jbussmann/8-Cell-Balancer/Hardware/Pictures/3D_Top.png

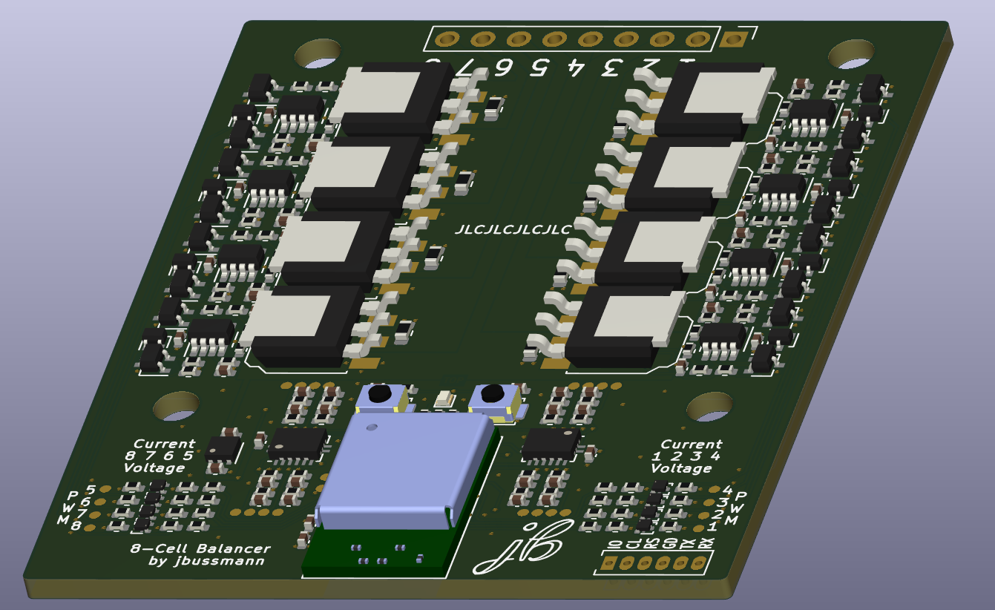
Hardware/Pictures/3D_Top.png
