jbussmann/8-Cell-Balancer/Hardware/PDF/8-Cell Balancer.pdf

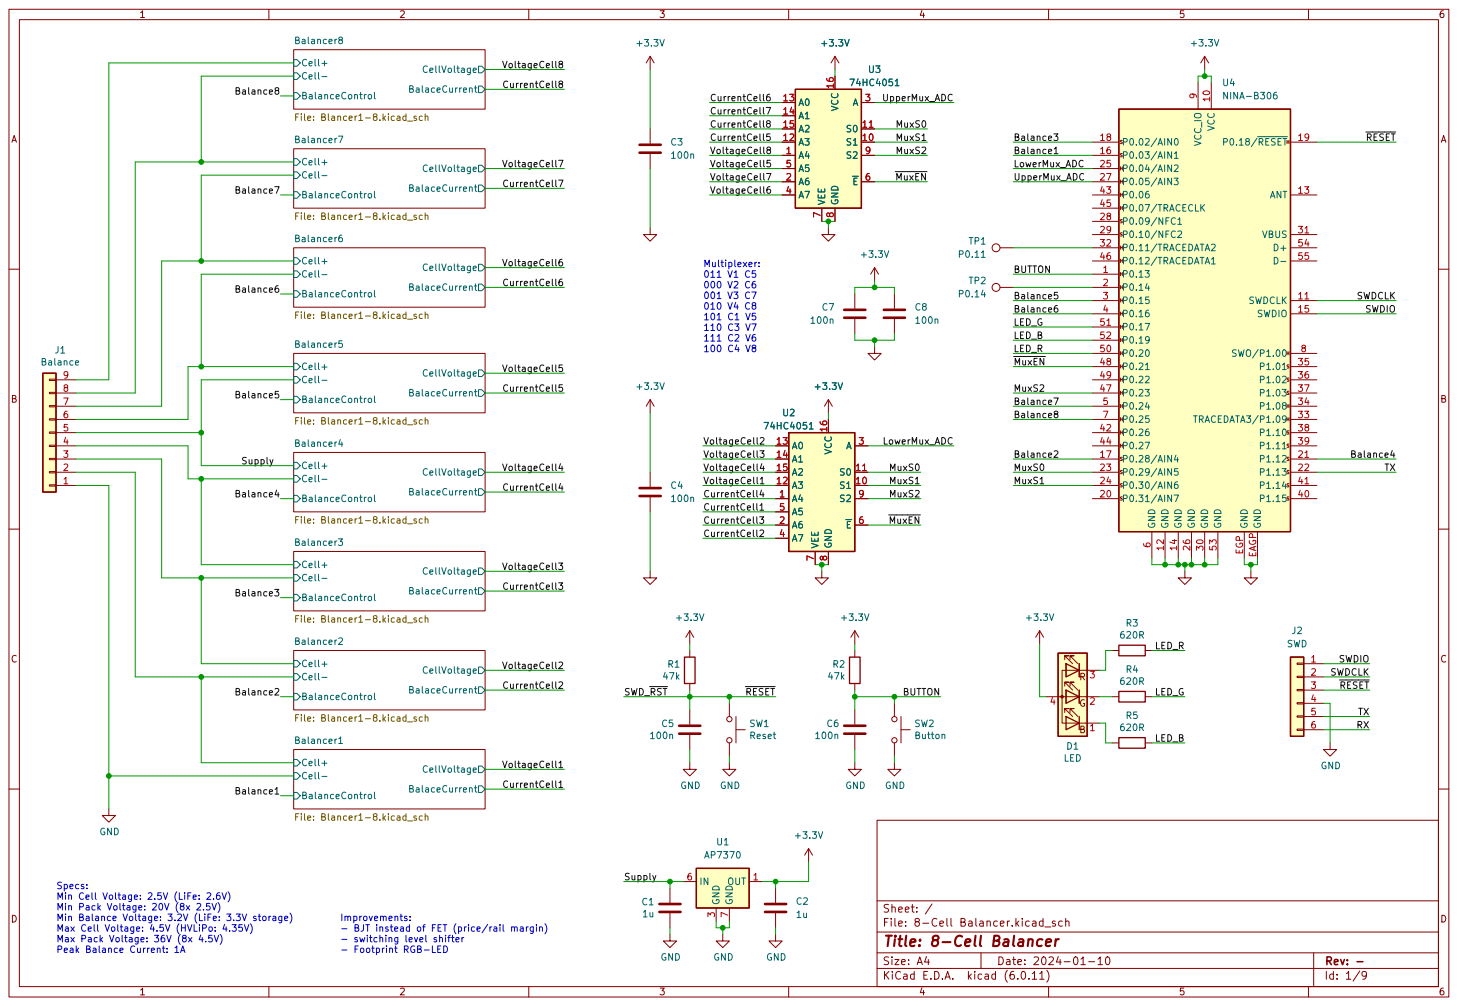
[picture p2: page 1]

9 GND EAGP GND EGP U4 NINA-B306 A4

Specs: Min Cell Voltage: 2.5V (LiFe: 2.6V) Min Pack Voltage: 20V (8x 2.5V) Min Balance Voltage: 3.2V (LiFe: 3.3V storage) Max Cell Voltage: 4.5V (HVLiPo: 4.35V) Max Pack Voltage: 36V (8x 4.5V) Peak Balance Current: 1A

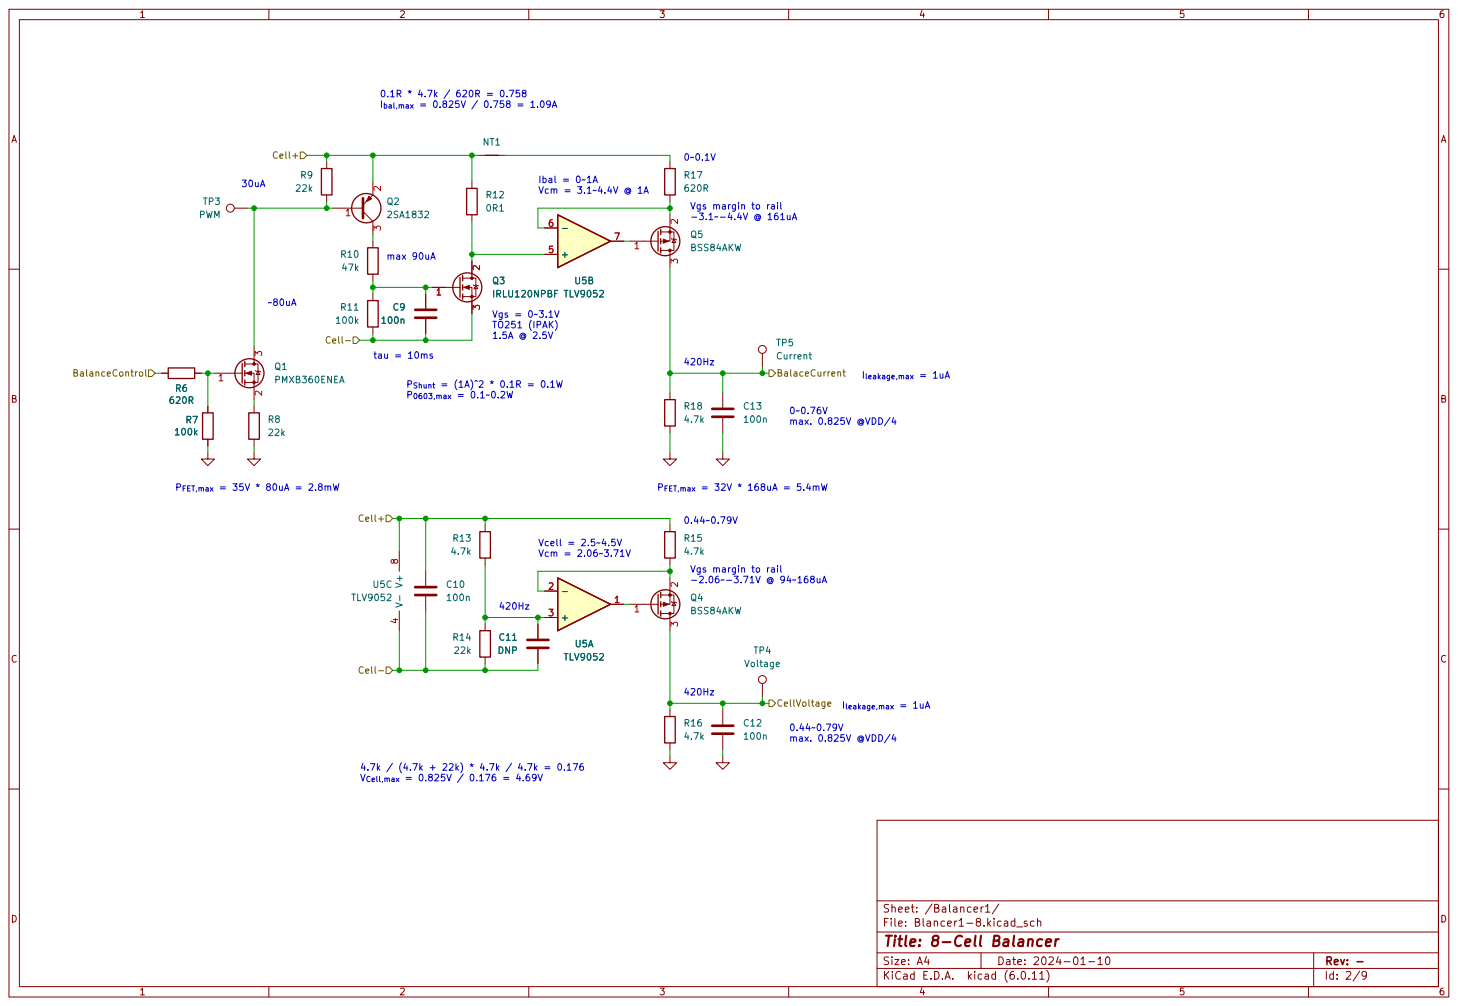
[picture p3: page 2]

0.44~0.79V max. 0.825V @VDD/4 P_{FET,max} = 32V * 168uA = 5.4mW

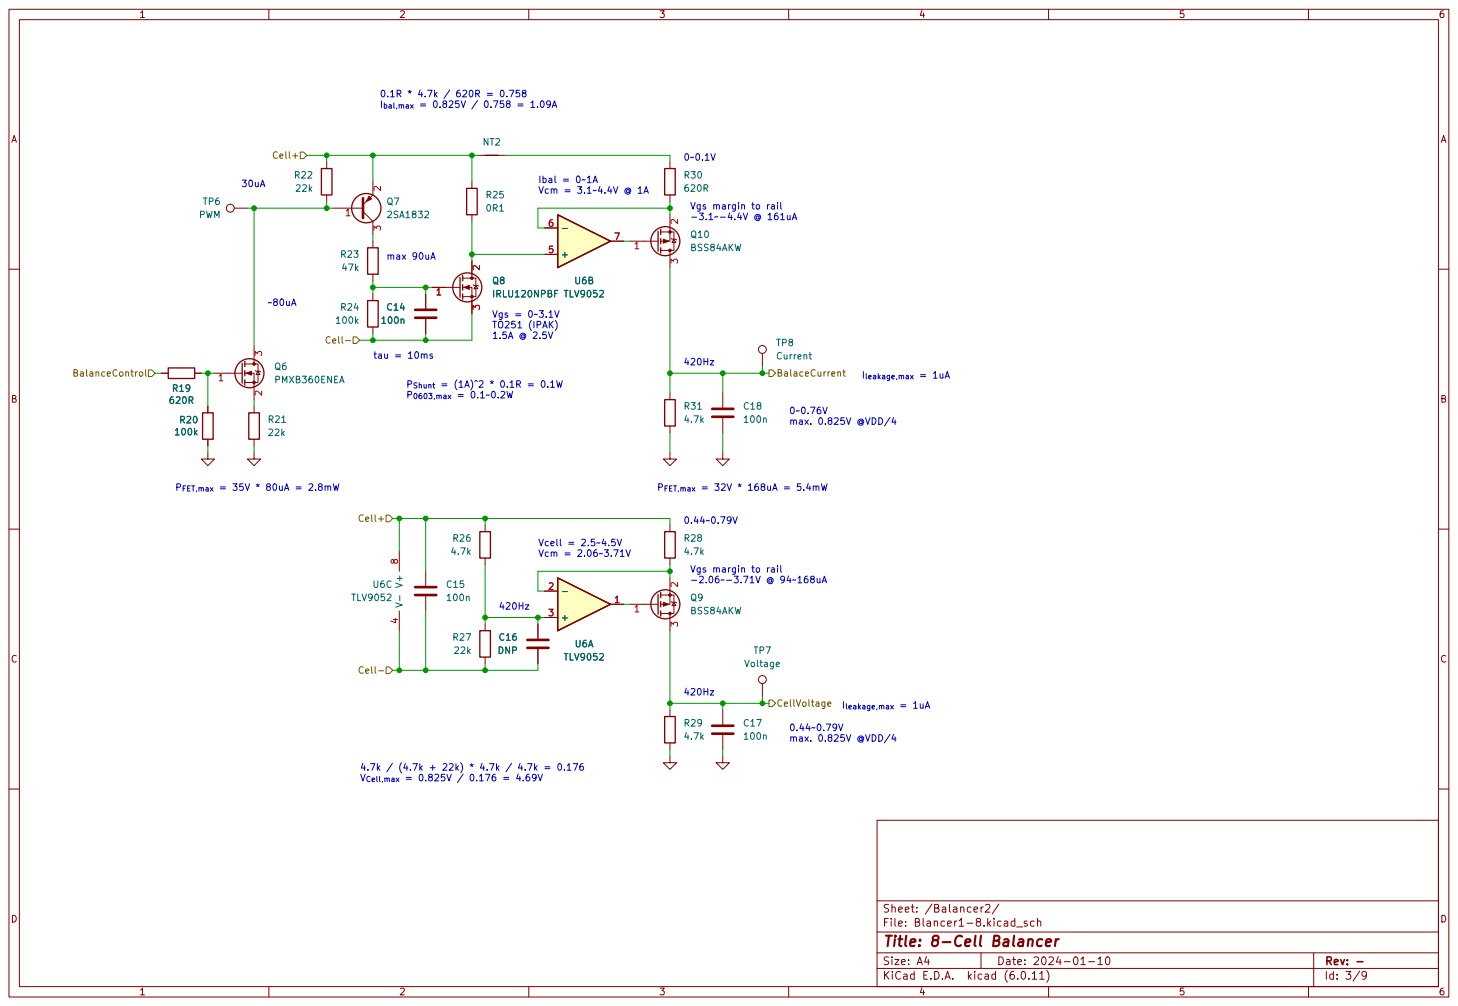
[picture p4: page 3]

0.44~0.79V max. 0.825V @VDD/4 P_{FET,max} = 32V * 168uA = 5.4mW

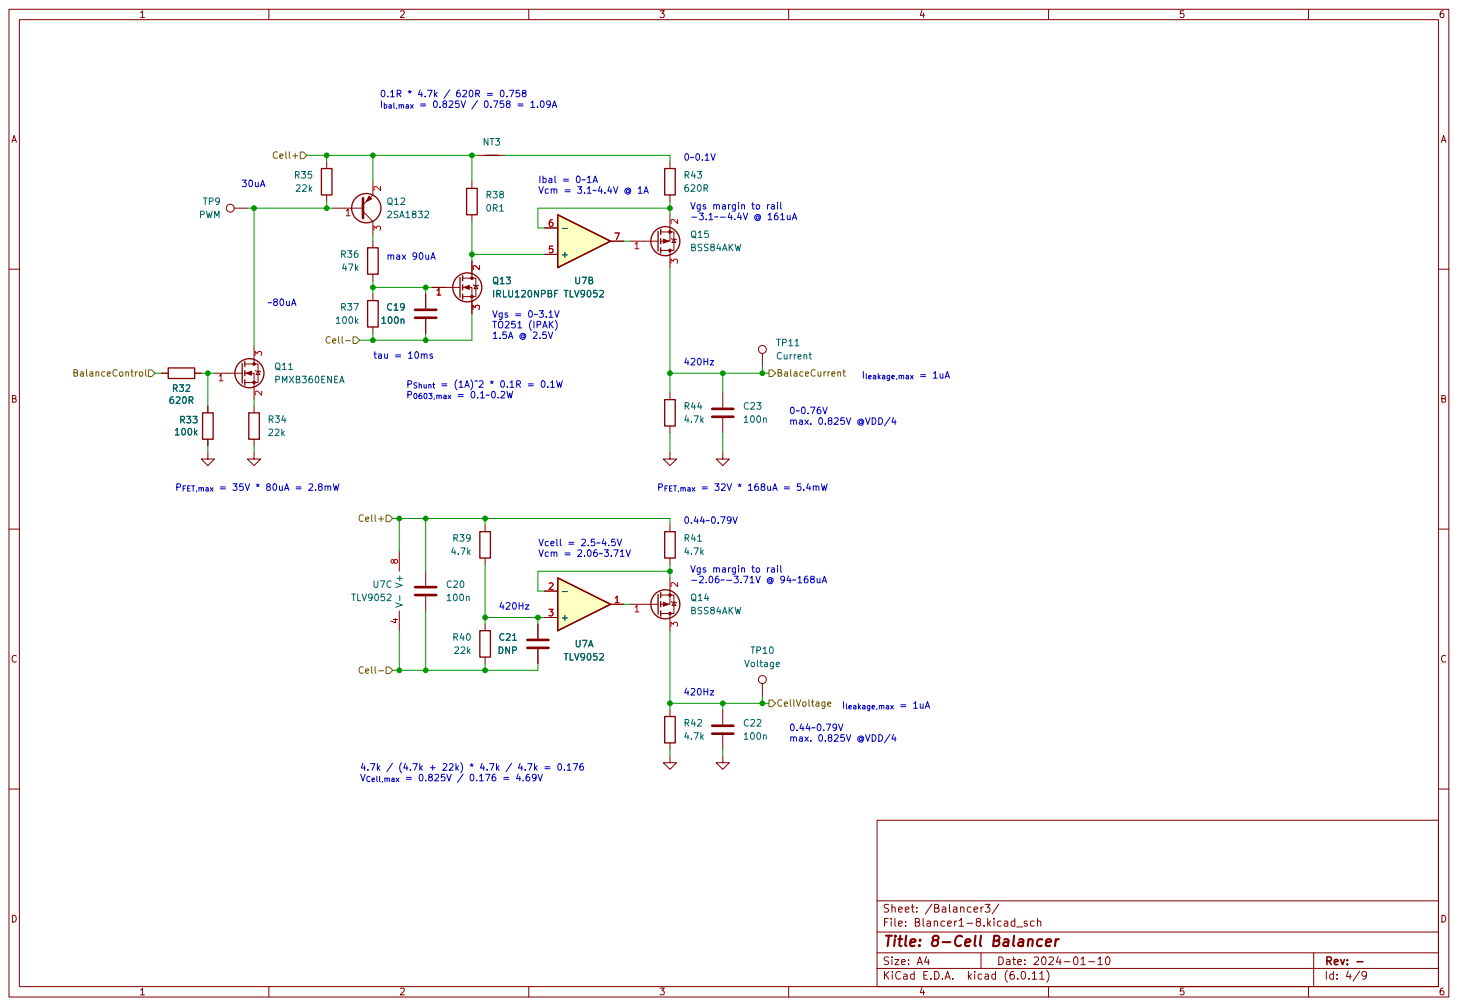
[picture p5: page 4]

0.44~0.79V max. 0.825V @VDD/4 P_{FET,max} = 32V * 168uA = 5.4mW

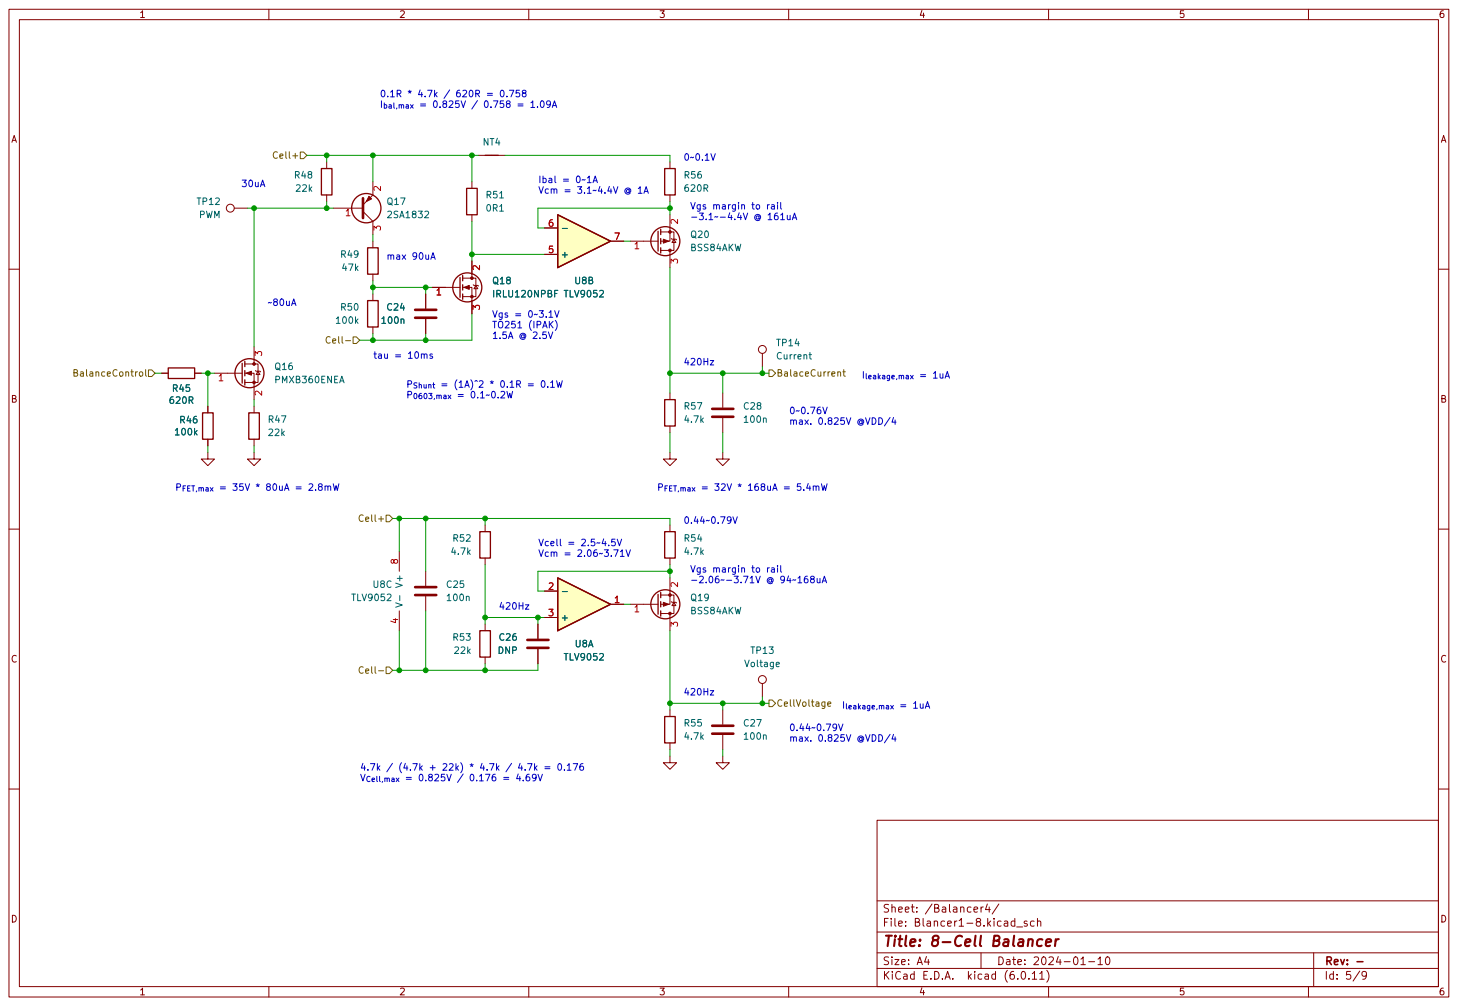
[picture p6: page 5]

0.44~0.79V max. 0.825V @VDD/4 P_{FET,max} = 32V * 168uA = 5.4mW

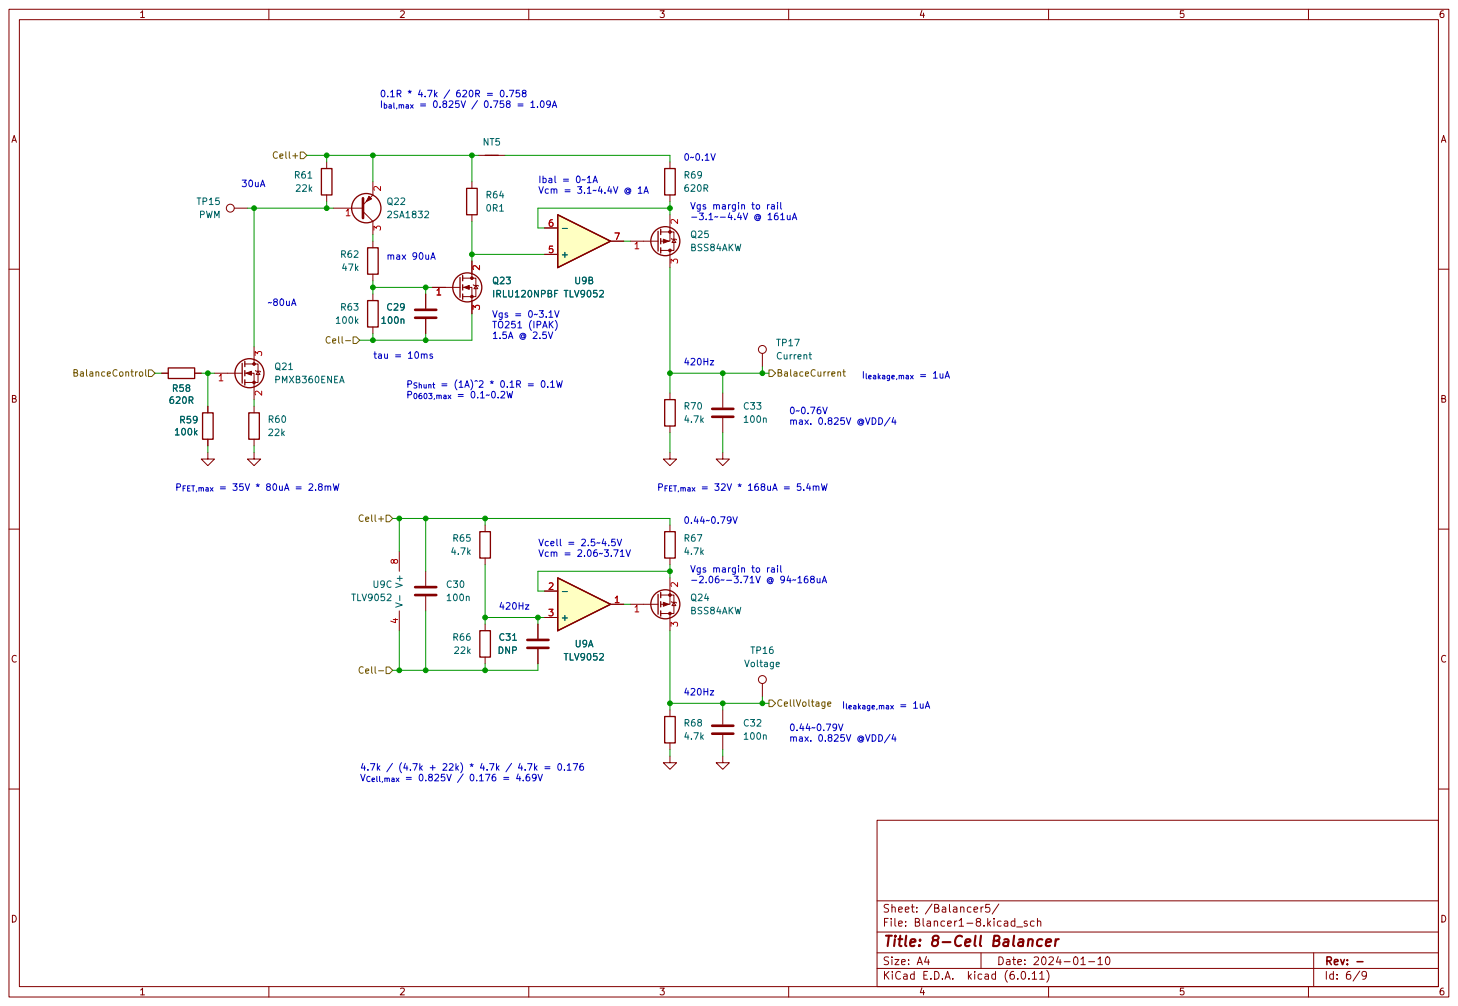
[picture p7: page 6]

0.44~0.79V max. 0.825V @VDD/4 P_{FET,max} = 32V * 168uA = 5.4mW

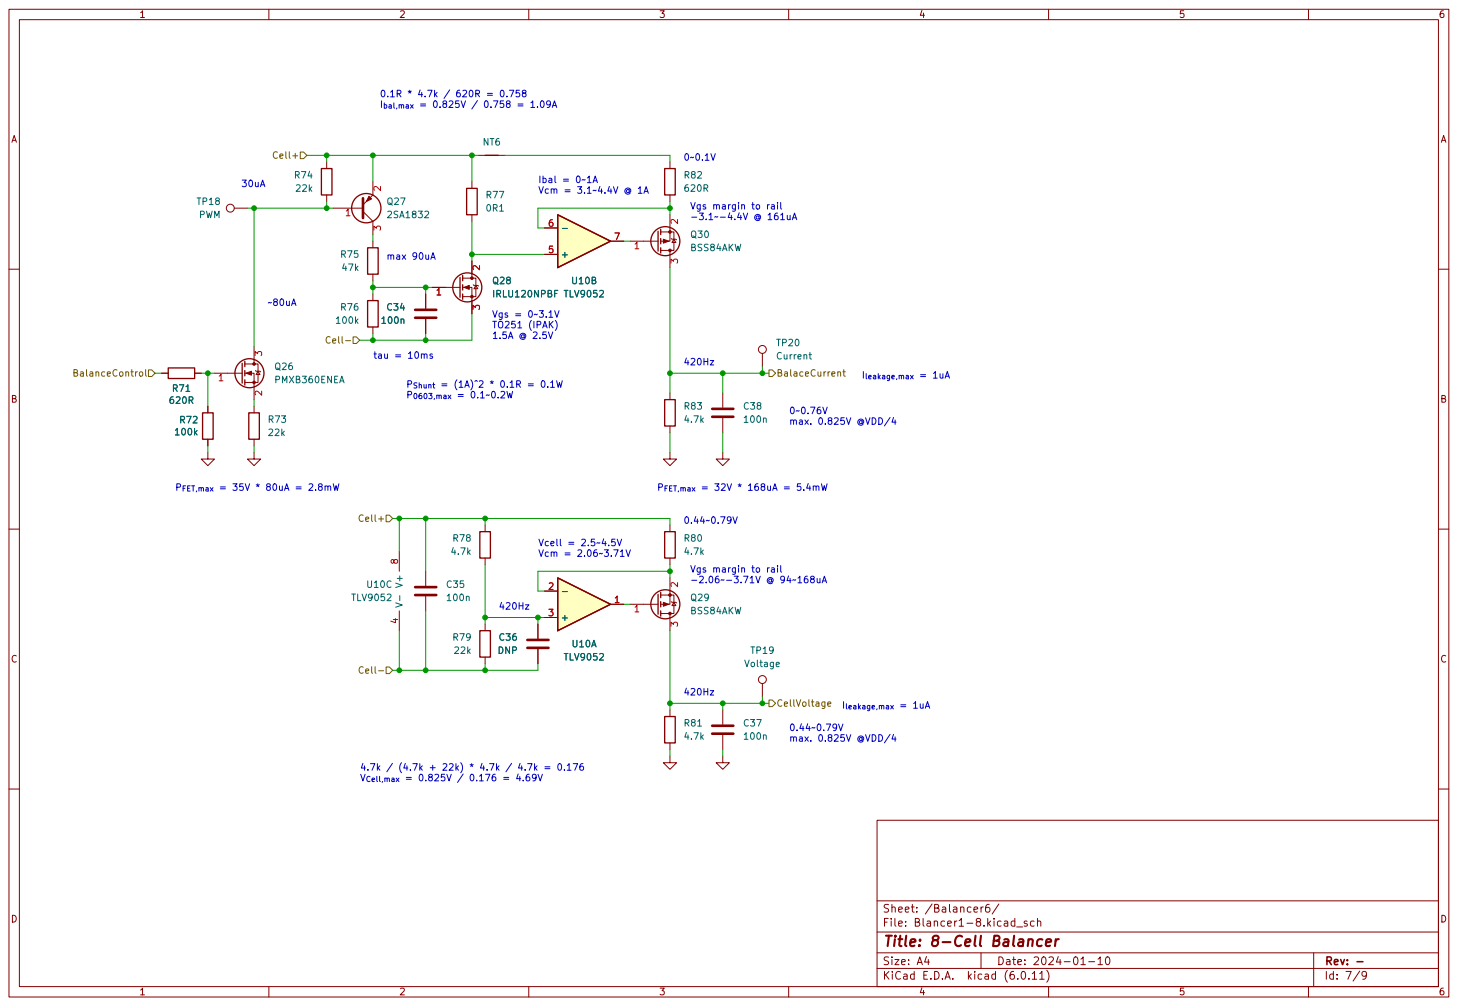
[picture p8: page 7]

0.44~0.79V max. 0.825V @VDD/4 P_{FET,max} = 32V * 168uA = 5.4mW

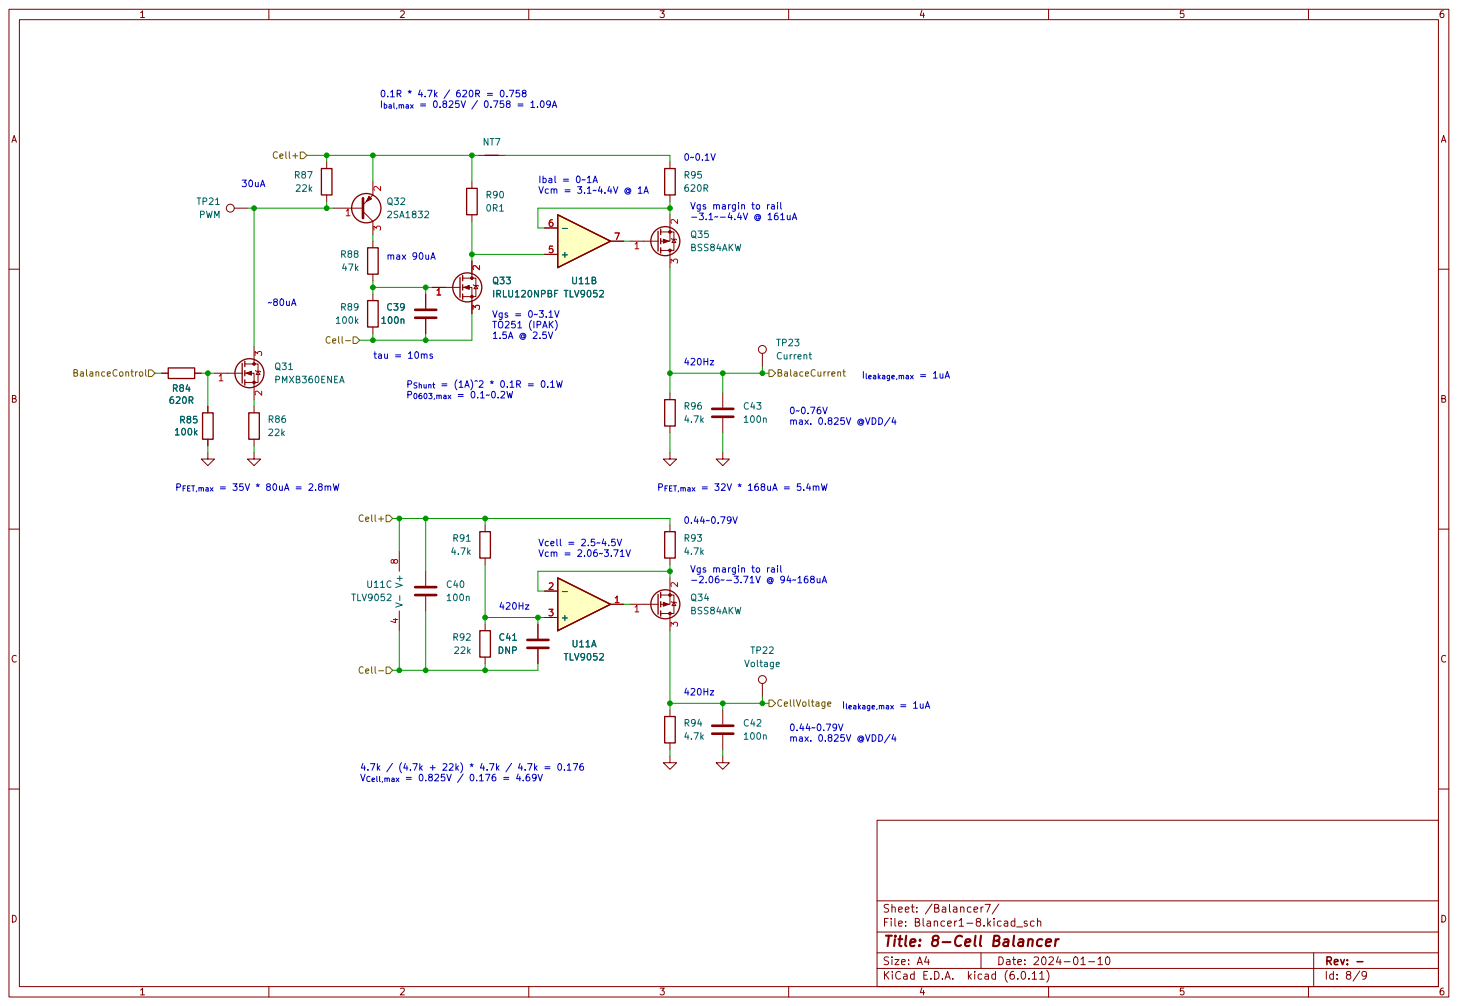
[picture p9: page 8]

0.44~0.79V max. 0.825V @VDD/4 P_{FET,max} = 32V * 168uA = 5.4mW

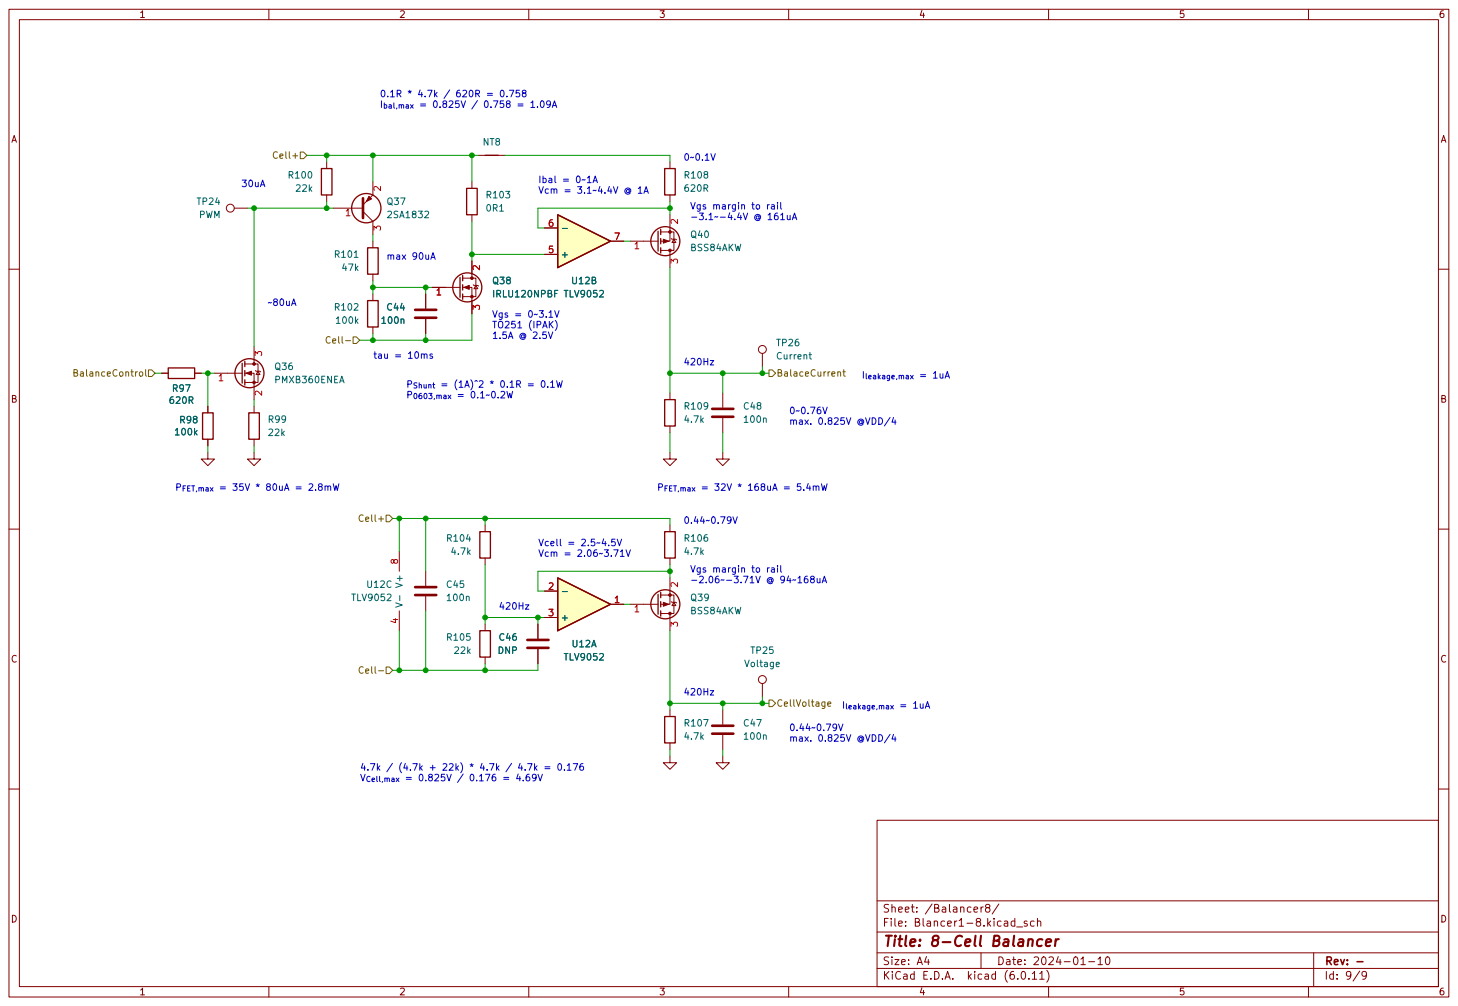
[picture p10: page 9]

0.44~0.79V max. 0.825V @VDD/4 P_{FET,max} = 32V * 168uA = 5.4mW
