jbussmann/8-Cell-Balancer/Notes/Hardware.pdf

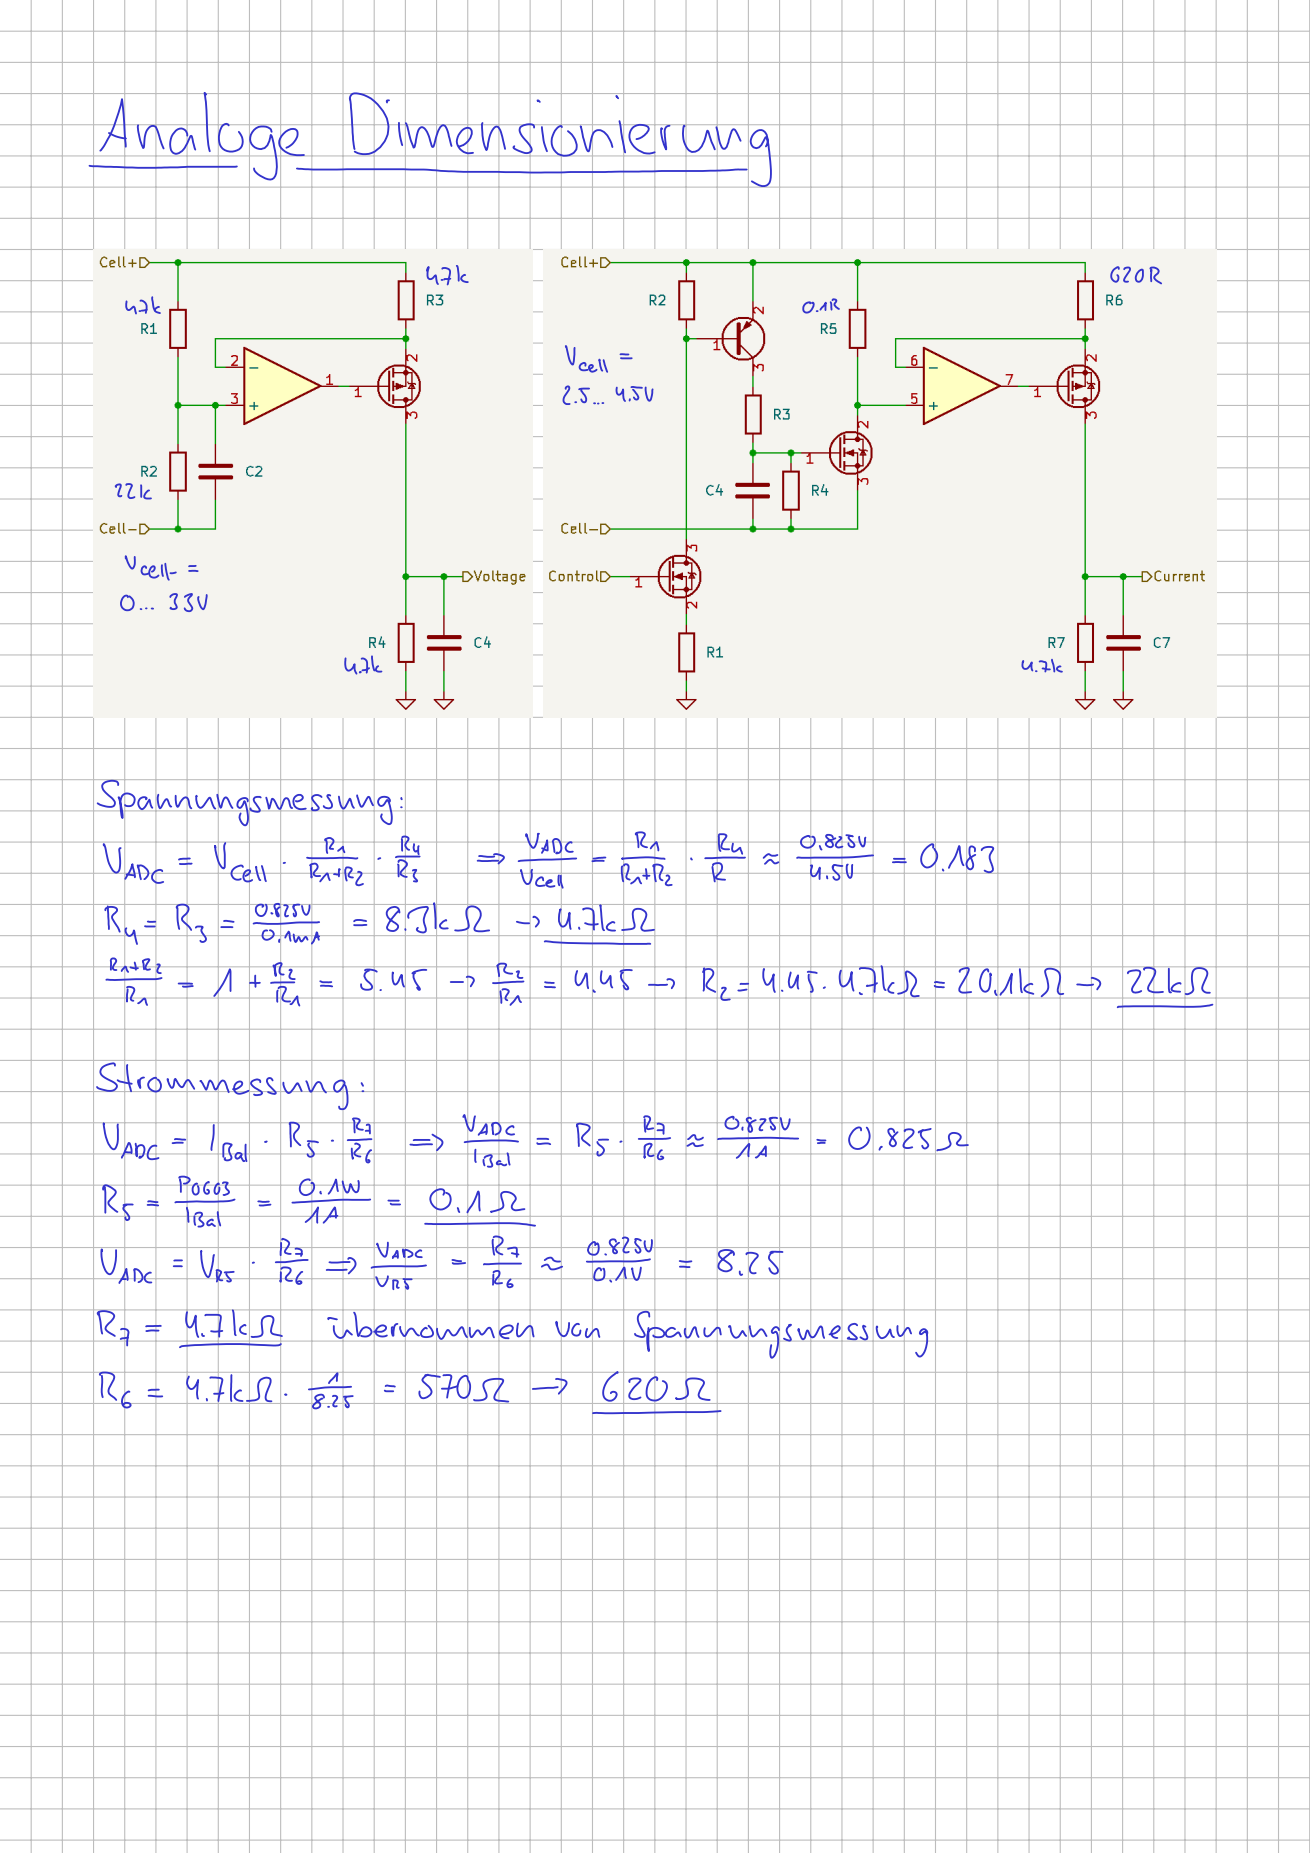
[picture p11: page 1]

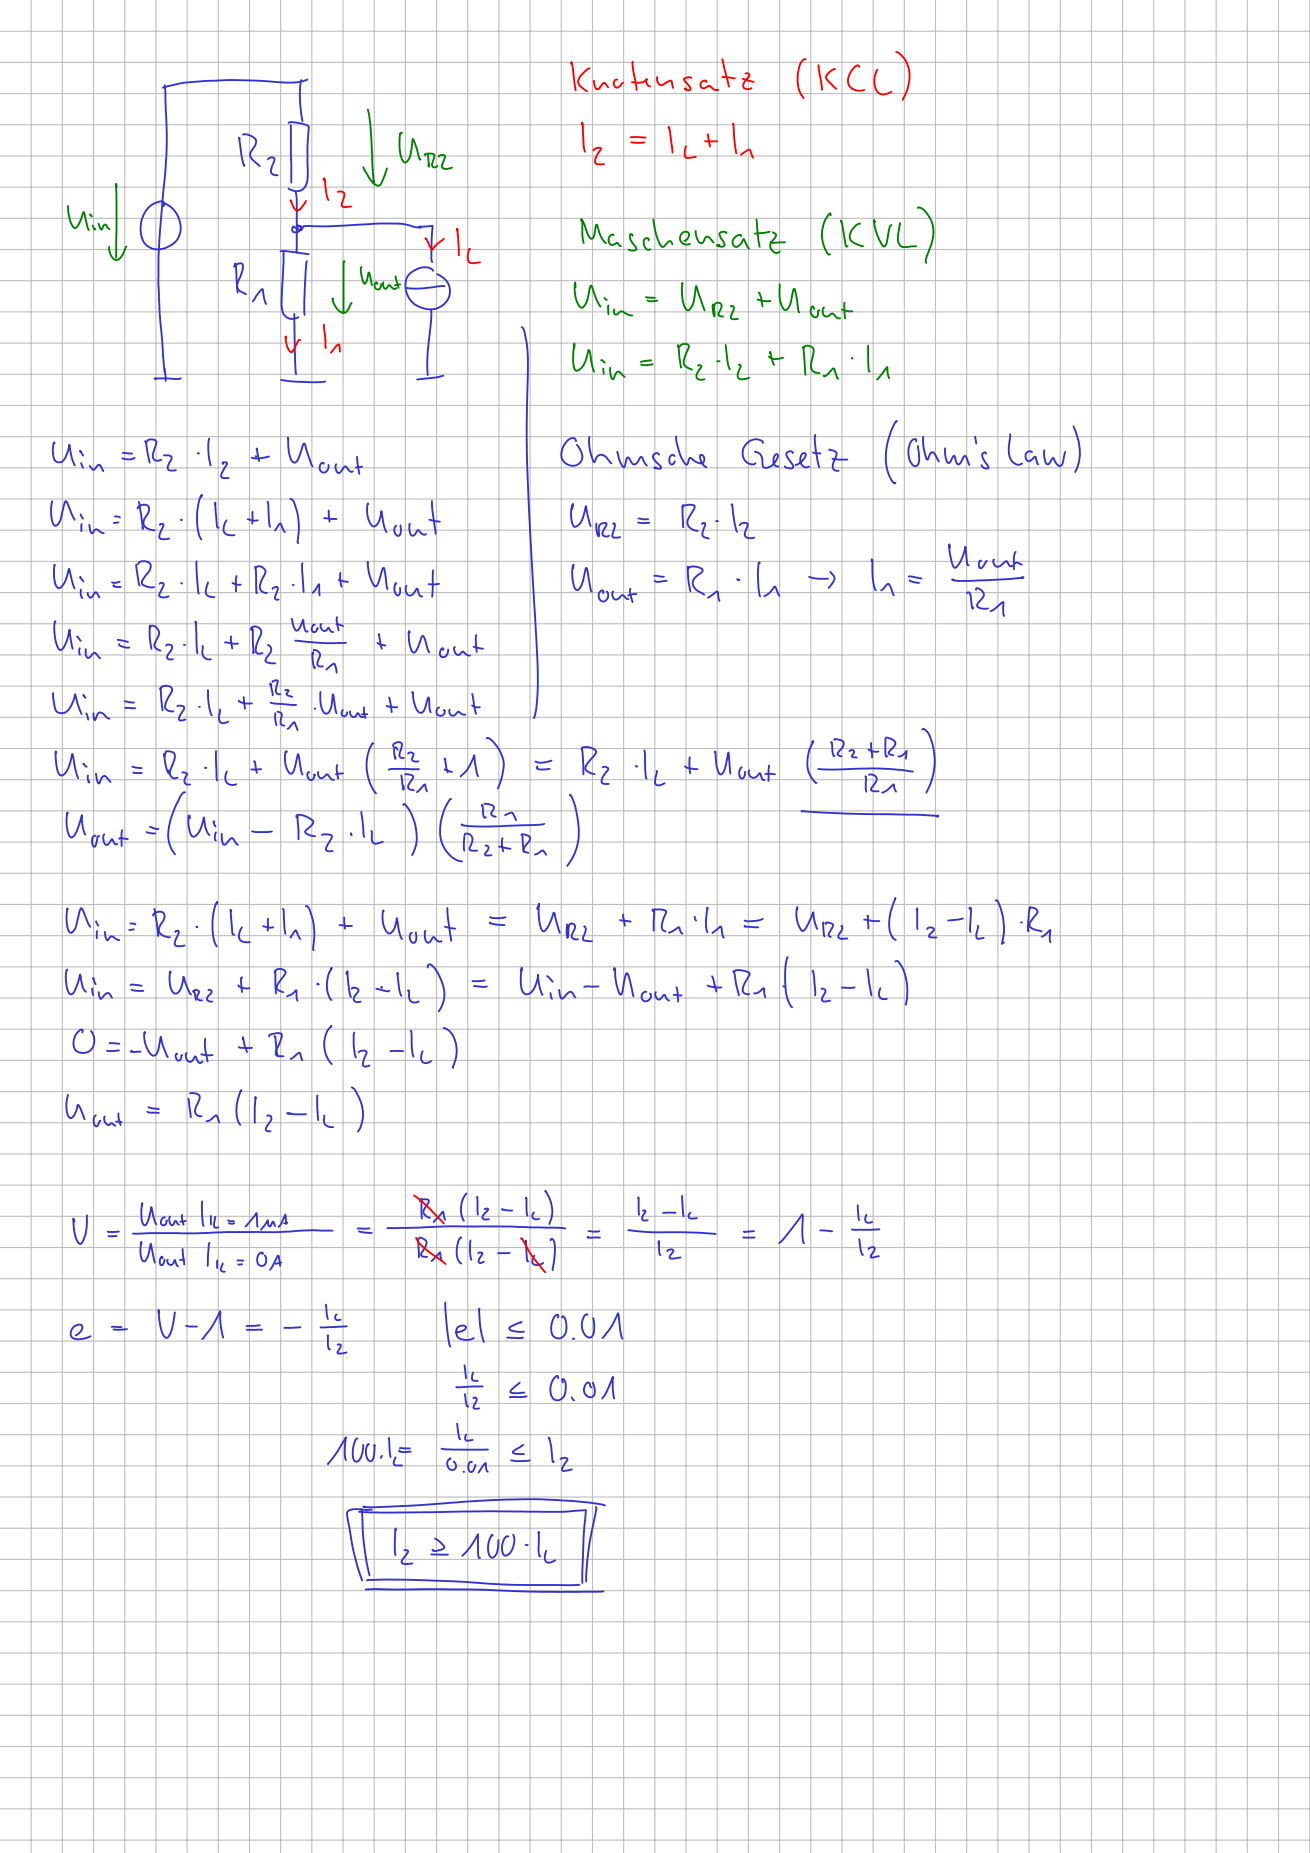
[picture p12: page 2]
