jbussmann/8-Cell-Balancer/Spice/Level-Shifter_Capacitor.asc

C1: cap; 3.3n
C2: cap; 100n
D1: diode; Diode
D2: diode; Diode
D3: diode; Diode
M1: nmos; Power-FET
R1: res; 6.6k
R2: res; 330k
R3: res; 0.1
V1: voltage; PULSE(0 3.3 3m 1n 1n 50u 100u 90); Rser=200
V2: voltage; PULSE(0 30 1m 1n 1n 14m)
V3: voltage; PULSE(0 3.6 2m 1n 1n 13m)
Named nets: 0, Cell-, Cell+
.tran 25m startup
- high turn on current
- what happens on turn off? MOSFET requires gate protection
.model Diode D(Ron=1 Roff=1G Vfwd=0.3)
 
.MODEL Power-FET NMOS LEVEL=1 IS=1e-32
+VTO=1.53268 LAMBDA=0.00113312 KP=2.28626
+CGSO=3.98923e-06 CGDO=3.14722e-07
tau = 33us
Std drive: 0.4V / 0.002A = 200Ohm
High drive: 0.4V / 0.01A = 40Ohm
