jbussmann/8-Cell-Balancer/Spice/Balancer_current.asc

C1: cap; 100n
C2: cap; 100n
D1: diode
M1: pmos
M2: nmos
M3: nmos
R1: res; 0.1
R2: res; 270k
R3: res; 330k
R4: res; 10k
R5: res; 10k
R6: res; 100k
R9: res; 200k
U1: UniversalOpAmp2
V1: voltage; PWL(0 2.5 200m 2.5 800m 4.5 1 4.5)
V2: voltage; 20
V3: voltage; PULSE(0 3.3 0 0 0 0.08m 0.1m 505)
Named nets: 0
.tran 100m
