jbussmann/8-Cell-Balancer/Spice/Balancer_voltage.asc

C1: cap; 00n
C2: cap; 100n
C4: cap; 100n
M1: pmos; P-MOS
R1: res; 4.7k
R2: res; 22k
R3: res; 4.7k
R4: res; 4.7k
U1: UniversalOpAmp2
V1: voltage; PWL(0 2.5 100m 2.5 400m 4.5 480m 4.5 490m 2.5 600m 2.5 900m 4.5 1 4.5); AC 1
V2: voltage; PWL(0 0 510m 0 520m 20 1 20)
Named nets: 0, Vg, Vs, Vd
.ac dec 100 1 1meg
.MODEL P-MOS PMOS(Vto=-1.66 Kp=1.3807e-01
+ Nfs=1000000000 Eta=0 Level=3 L=1e-4 W=1e-4 
+ Gamma=0 Phi=0.6 Is=1e-24 Js=0 Pb=0.8  Cj=0 
+ Cjsw=0 Cgso=0 Cgdo=0 Cgbo=0 Tox=1e-07 Xj=0
+ U0=600 Vmax=3000)
