jbussmann/8-Cell-Balancer/Spice/Level-Shifter_Transistor.asc

C2: cap; 100n
M1: nmos; Power-FET
M2: nmos; Power-FET
Q1: pnp
R1: res; 47k
R2: res; 100k
R3: res; 0.1
R4: res; 22k
R5: res; 22k
R6: res; 100k
R7: res; 620
V1: voltage; PULSE(0 3.3 3m 1n 1n 90u 100u 140)
V2: voltage; PULSE(0 30 1m 1n 1n 19m)
V3: voltage; PULSE(0 4.35 2m 1n 1n 18m)
Named nets: 0, Cell-, Cell+
.tran 25m startup
- more parts
- dependant on cell voltage
.MODEL Diode D(Ron=1 Roff=1G Vfwd=0.3)
 
.MODEL Power-FET NMOS LEVEL=1 IS=1e-32
+ VTO=1.53268 LAMBDA=0.00113312 KP=2.28626
+ CGSO=3.98923e-06 CGDO=3.14722e-07
 
.MODEL PNP PNP(LEVEL=1 TNOM=25 IS=2.5e-014 
+ BF=190 NF=1 VAF=30 IKF=0.3 ISE=1E-016 
+ NE=1.5 BR=15 NR=1 VAR=1000 IKR=0.01 
+ ISC=4e-013 NC=1.4 NK=0.53 RE=0.001 
+ RB=8 RC=1.1 CJE=9.0E-012 VJE=0.75 MJE=0.33 
+ CJC=9.63E-012 VJC=0.75 MJC=0.33 FC=0.5 
+ TR=4e-008 TF=1.78E-009 XTF=1 VTF=1 ITF=1 
+ PTF=0 EG=1.11 TRC1=0 XTB=2 XTI=2)
 
.MODEL N-MOS NMOS(Vto=2.13003650017072 
+ Kp=7.411324e+000 Nfs=500000000000 Eta=5000 
+ Level=3 L=1e-4 W=1e-4 Gamma=0 Phi=0.6 
+ Is=1e-24 Js=0 Pb=0.8 Cj=0 Cjsw=0 Cgso=0 
+ Cgdo=0 Cgbo=0 Tox=1e-07 Xj=0 U0=600 Vmax=2000)
