jbussmann/8-Cell-Balancer/Hardware/8-Cell Balancer.kicad_pcb

## KiCad design Hardware/8-Cell Balancer.kicad_pcb (2025-03-06)

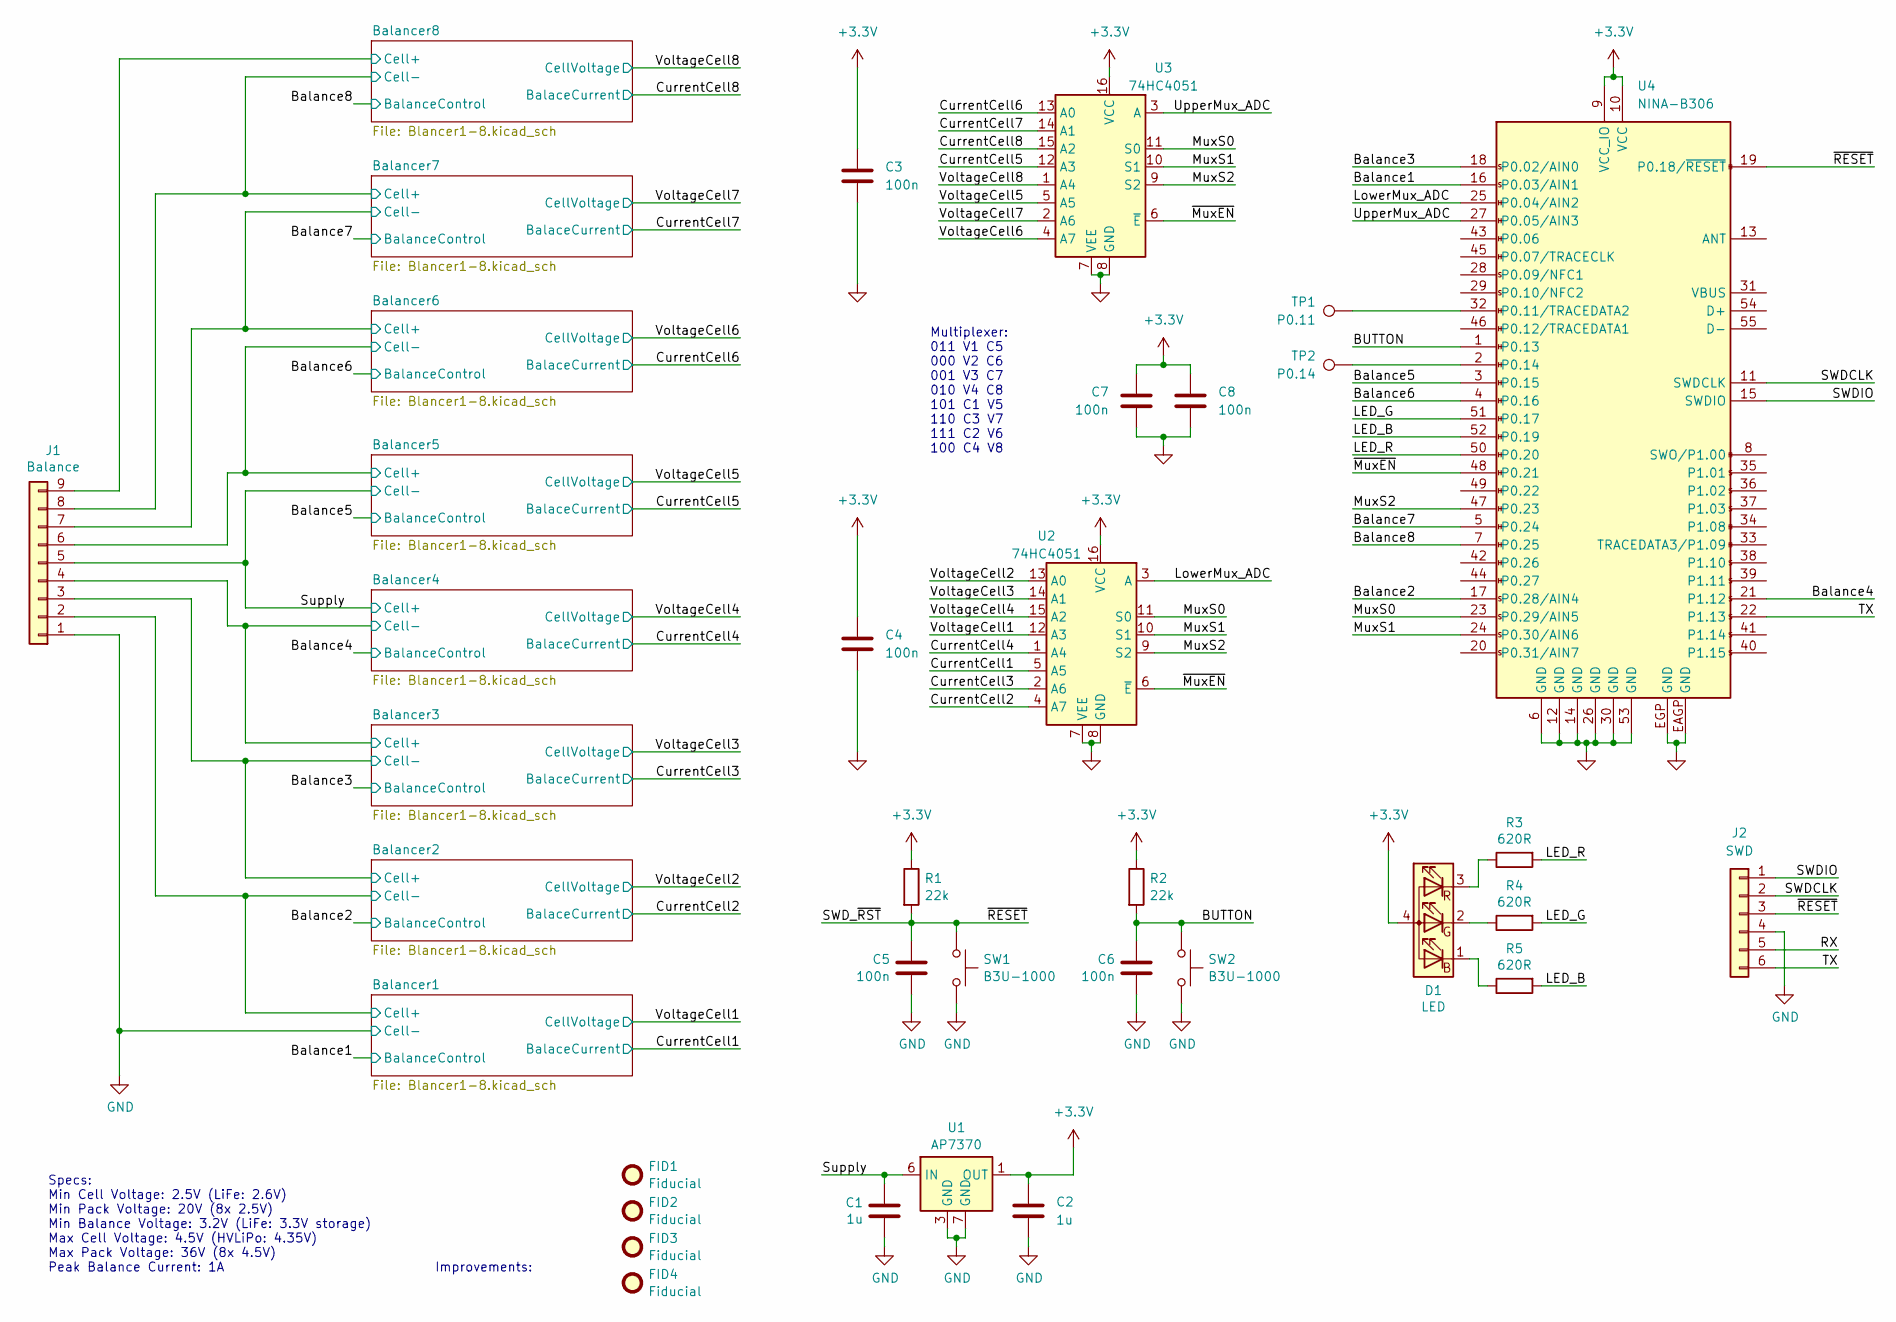
[picture p18: schematic 8-Cell Balancer.kicad_sch]

Parts:
C1, C2: 1u; C_0603_1608Metric; Mfr. Part# GRT188R61H105KE13D; Mouser Part# 81-GRT188R61H105KE3D
C3, C4, C5, C6, C7, C8: 100n; C_0402_1005Metric; Mfr. Part# GRM155R71C104KA88D; Mouser Part# 81-GRM155R71C104KA88
D1: LED; LED_RGB_1x1mm; Mfr. Part# UHD1110-FKA-CL1A13r3q1BBQFMF3; Mouser Part# 941-UHD0FKAC11BQFMF3
FID1, FID2, FID3, FID4: Fiducial; Fiducial_1mm_Mask2mm
J1: Balance; PinHeader_1x09_P2.54mm_Vertical
J2: SWD; PinHeader_1x06_P1.27mm_Vertical
R1, R2: 22k; R_0402_1005Metric; Mfr. Part# RC0402FR-0722KL; Mouser Part# 603-RC0402FR-0722KL
R3, R4, R5: 620R; R_0402_1005Metric; Mfr. Part# RC0402FR-07620RL; Mouser Part# 603-RC0402FR-07620RL
SW1, SW2: B3U-1000; Button_B3U-1000; Mfr. Part# B3U-1000P-B; Mouser Part# 653-B3U-1000P-B
TP1: P0.11; TestPoint_Pad_D1.0mm
TP2: P0.14; TestPoint_Pad_D1.0mm
U1: AP7370; Diodes_UDFN2020-6; Mfr. Part# AP7370-33FDC-7; Mouser Part# 621-AP7370-33FDC-7
U2, U3: 74HC4051; QFN-16-1EP_2.5x3.5mm_P0.5mm_EP1x2.5mm; Mfr. Part# 74LV4051BQ,115; Mouser Part# 771-LV4051BQ115
U4: NINA-B306; Module_ublox_NINA-B306; Mfr. Part# NINA-B306-00B; Mouser Part# 377-NINA-B306-00B

Connections:
+3.3V: C2.1, C3.1, C4.1, C7.1, C8.1, D1.4 (A), R1.1, R2.1, U1.1 (OUT), U2.16 (VCC), U3.16 (VCC), U4.9 (VCC_IO), U4.10 (VCC)
/BUTTON: C6.1, R2.2, SW2.1, U4.1 (P0.13)
/Balance1: U4.16 (P0.03/AIN1); also elsewhere on the board
/Balance2: U4.17 (P0.28/AIN4); also elsewhere on the board
/Balance3: U4.18 (P0.02/AIN0); also elsewhere on the board
/Balance4: U4.21 (P1.12); also elsewhere on the board
/Balance5: U4.3 (P0.15); also elsewhere on the board
/Balance6: U4.4 (P0.16); also elsewhere on the board
/Balance7: U4.5 (P0.24); also elsewhere on the board
/Balance8: U4.7 (P0.25); also elsewhere on the board
/Balancer1/Cell+: J1.2; also elsewhere on the board
/Balancer2/Cell+: J1.3; also elsewhere on the board
/Balancer3/Cell+: J1.4; also elsewhere on the board
/Balancer5/Cell+: J1.6; also elsewhere on the board
/Balancer6/Cell+: J1.7; also elsewhere on the board
/Balancer7/Cell+: J1.8; also elsewhere on the board
/Balancer8/Cell+: J1.9; also elsewhere on the board
/CurrentCell1: U2.5 (A5); also elsewhere on the board
/CurrentCell2: U2.4 (A7); also elsewhere on the board
/CurrentCell3: U2.2 (A6); also elsewhere on the board
/CurrentCell4: U2.1 (A4); also elsewhere on the board
/CurrentCell5: U3.12 (A3); also elsewhere on the board
/CurrentCell6: U3.13 (A0); also elsewhere on the board
/CurrentCell7: U3.14 (A1); also elsewhere on the board
/CurrentCell8: U3.15 (A2); also elsewhere on the board
/LED_B: R5.2, U4.52 (P0.19)
/LED_G: R4.2, U4.51 (P0.17)
/LED_R: R3.2, U4.50 (P0.20)
/LowerMux_ADC: U2.3 (A), U4.25 (P0.04/AIN2)
/MuxS0: U2.11 (S0), U3.11 (S0), U4.23 (P0.29/AIN5)
/MuxS1: U2.10 (S1), U3.10 (S1), U4.24 (P0.30/AIN6)
/MuxS2: U2.9 (S2), U3.9 (S2), U4.47 (P0.23)
/RX: J2.5
/SWDCLK: J2.2, U4.11 (SWDCLK)
/SWDIO: J2.1, U4.15 (SWDIO)
/SWD_~RST: C5.1, J2.3, R1.2, SW1.1, U4.19 (P0.18/~RESET)
/Supply: C1.1, J1.5, U1.6 (IN); also elsewhere on the board
/TX: J2.6, U4.22 (P1.13)
/UpperMux_ADC: U3.3 (A), U4.27 (P0.05/AIN3)
/VoltageCell1: U2.12 (A3); also elsewhere on the board
/VoltageCell2: U2.13 (A0); also elsewhere on the board
/VoltageCell3: U2.14 (A1); also elsewhere on the board
/VoltageCell4: U2.15 (A2); also elsewhere on the board
/VoltageCell5: U3.5 (A5); also elsewhere on the board
/VoltageCell6: U3.4 (A7); also elsewhere on the board
/VoltageCell7: U3.2 (A6); also elsewhere on the board
/VoltageCell8: U3.1 (A4); also elsewhere on the board
/~MuxEN: U2.6 (~E), U3.6 (~E), U4.48 (P0.21)
GND: C1.2, C2.2, C3.2, C4.2, C5.2, C6.2, C7.2, C8.2, J1.1, J2.4, SW1.2, SW2.2, U1.3 (GND), U1.7 (GND), U2.7 (VEE), U2.8 (GND), U3.7 (VEE), U3.8 (GND), U4.6 (GND), U4.12 (GND), U4.14 (GND), U4.26 (GND), U4.30 (GND), U4.53 (GND), U4.EAGP (GND), U4.EGP (GND); also elsewhere on the board
unnamed: D1.1 (BK), R5.1
unnamed: D1.2 (GK), R4.1
unnamed: D1.3 (RK), R3.1
unnamed: TP1.1, U4.32 (P0.11/TRACEDATA2)
unnamed: TP2.1, U4.2 (P0.14)

Notes on the sheet:
Improvements:
Specs: Min Cell Voltage: 2.5V (LiFe: 2.6V) Min Pack Voltage: 20V (8x 2.5V) Min Balance Voltage: 3.2V (LiFe: 3.3V storage) Max Cell Voltage: 4.5V (HVLiPo: 4.35V) Max Pack Voltage: 36V (8x 4.5V) Peak Balance Current: 1A
Multiplexer: 011 V1 C5 000 V2 C6 001 V3 C7 010 V4 C8 101 C1 V5 110 C3 V7 111 C2 V6 100 C4 V8

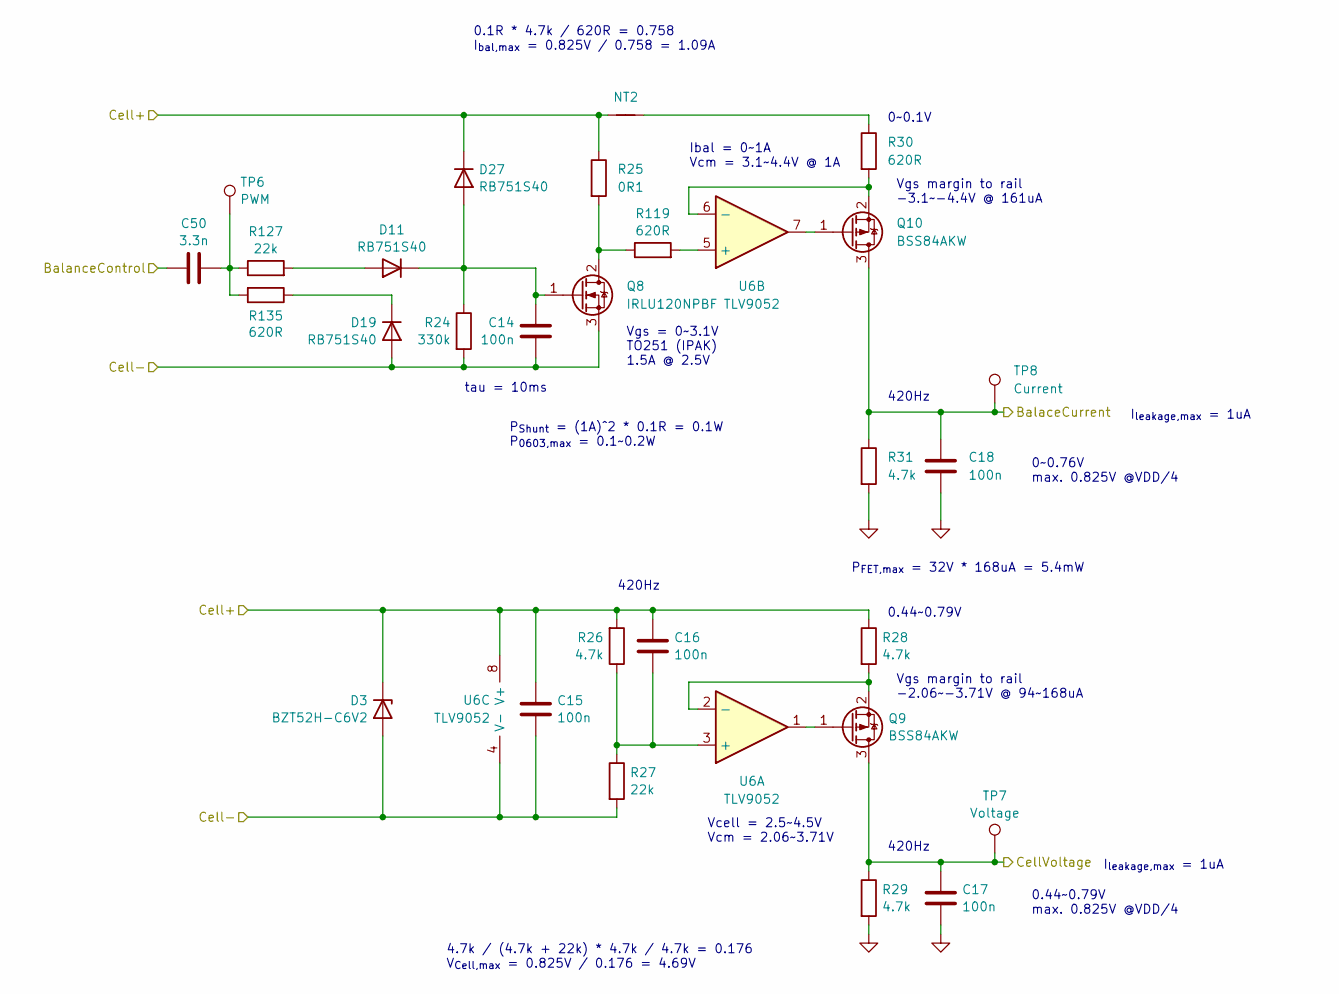
[picture p19: schematic Blancer1-8.kicad_sch, 8-Cell Balancer]

Parts:
C14, C15, C16, C17, C18: 100n; C_0402_1005Metric; Mfr. Part# GRM155R71C104KA88D; Mouser Part# 81-GRM155R71C104KA88
C50: 3.3n; C_0402_1005Metric; Mfr. Part# GRM1555C1H332JE01D; Mouser Part# 81-GRM1555C1H332JE1D
D3: BZT52H-C6V2; D_SOD-123F; Mfr. Part# BZT52H-C6V2,115; Mouser Part# 771-BZT52H-C6V2-T/R
D11, D19, D27: RB751S40; D_SOD-523; Mfr. Part# RB751S40T5G; Mouser Part# 863-RB751S40T5G
NT2: NetTie; NetTie-2_SMD_Pad0.127mm
Q8: IRLU120NPBF; TO-251-3_Flipped; Mfr. Part# IRLU120NPBF; Mouser Part# 942-IRLU120NPBF
Q9, Q10: BSS84AKW; SOT-323_SC-70; Mfr. Part# BSS84AKW,115; Mouser Part# 771-BSS84AKW115
R24: 330k; R_0402_1005Metric; Mfr. Part# RC0402FR-0722KL; Mouser Part# 603-RC0402FR-0722KL
R25: 0R1; R_0603_1608Metric; Mfr. Part# PT0603FR-7W0R1L; Mouser Part# 603-PT0603FR-7W0R1L
R26, R28, R29, R31: 4.7k; R_0402_1005Metric; Mfr. Part# RC0402FR-134K7L; Mouser Part# 603-RC0402FR-134K7L
R27, R127: 22k; R_0402_1005Metric; Mfr. Part# RC0402FR-0722KL; Mouser Part# 603-RC0402FR-0722KL
R30, R119, R135: 620R; R_0402_1005Metric; Mfr. Part# RC0402FR-07620RL; Mouser Part# 603-RC0402FR-07620RL
TP6: PWM; TestPoint_Pad_D1.0mm
TP7: Voltage; TestPoint_Pad_D1.0mm
TP8: Current; TestPoint_Pad_D1.0mm
U6: TLV9052; SOT-23-8; Mfr. Part# TLV9052IDDFR; Mouser Part# 595-TLV9052IDDFR

Connections:
/Balance2: C50.1; also elsewhere on the board
/Balancer1/Cell+: C14.2, C15.2, D3.2 (A), D19.2 (A), Q8.3 (S), R24.2, R27.2, U6.4 (V-); also elsewhere on the board
/Balancer2/Cell+: C15.1, C16.1, D3.1 (K), D27.1 (K), NT2.1, R25.1, R26.2, R28.1, U6.8 (V+); also elsewhere on the board
/CurrentCell2: C18.1, Q10.3 (D), R31.1, TP8.1; also elsewhere on the board
/VoltageCell2: C17.1, Q9.3 (D), R29.1, TP7.1; also elsewhere on the board
GND: C17.2, C18.2, R29.2, R31.2; also elsewhere on the board
unnamed: C50.2, R127.1, R135.2, TP6.1
unnamed: D11.2 (A), R127.2
unnamed: C14.1, D11.1 (K), D27.2 (A), Q8.1 (G), R24.1
unnamed: D19.1 (K), R135.1
unnamed: NT2.2, R30.1
unnamed: Q8.2 (D), R25.2, R119.1
unnamed: Q9.1 (G), U6.1
unnamed: Q9.2 (S), R28.2, U6.2 (-)
unnamed: Q10.1 (G), U6.7
unnamed: Q10.2 (S), R30.2, U6.6 (-)
unnamed: C16.2, R26.1, R27.1, U6.3 (+)
unnamed: R119.2, U6.5 (+)

Parts of its further copies:
C9, C10, C11, C12, C13, C19, C20, C21, C22, C23, C24, C25, C26, C27, C28, C29, C30, C31, C32, C33, C34, C35, C36, C37, C38, C39, C40, C41, C42, C43, C44, C45, C46, C47, C48: 100n; C_0402_1005Metric; Mfr. Part# GRM155R71C104KA88D; Mouser Part# 81-GRM155R71C104KA88
C49, C51, C52, C53, C54, C55, C56: 3.3n; C_0402_1005Metric; Mfr. Part# GRM1555C1H332JE01D; Mouser Part# 81-GRM1555C1H332JE1D
D2, D4, D5, D6, D7, D8, D9: BZT52H-C6V2; D_SOD-123F; Mfr. Part# BZT52H-C6V2,115; Mouser Part# 771-BZT52H-C6V2-T/R
D10, D12, D13, D14, D15, D16, D17, D18, D20, D21, D22, D23, D24, D25, D26, D28, D29, D30, D31, D32, D33: RB751S40; D_SOD-523; Mfr. Part# RB751S40T5G; Mouser Part# 863-RB751S40T5G
NT1, NT3, NT4, NT5, NT6, NT7, NT8: NetTie; NetTie-2_SMD_Pad0.127mm
Q3, Q13, Q18, Q23, Q28, Q33, Q38: IRLU120NPBF; TO-251-3_Flipped; Mfr. Part# IRLU120NPBF; Mouser Part# 942-IRLU120NPBF
Q4, Q5, Q14, Q15, Q19, Q20, Q24, Q25, Q29, Q30, Q34, Q35, Q39, Q40: BSS84AKW; SOT-323_SC-70; Mfr. Part# BSS84AKW,115; Mouser Part# 771-BSS84AKW115
R11, R37, R50, R63, R76, R89, R102: 330k; R_0402_1005Metric; Mfr. Part# RC0402FR-0722KL; Mouser Part# 603-RC0402FR-0722KL
R12, R38, R51, R64, R77, R90, R103: 0R1; R_0603_1608Metric; Mfr. Part# PT0603FR-7W0R1L; Mouser Part# 603-PT0603FR-7W0R1L
R13, R15, R16, R18, R39, R41, R42, R44, R52, R54, R55, R57, R65, R67, R68, R70, R78, R80, R81, R83, R91, R93, R94, R96, R104, R106, R107, R109: 4.7k; R_0402_1005Metric; Mfr. Part# RC0402FR-134K7L; Mouser Part# 603-RC0402FR-134K7L
R14, R40, R53, R66, R79, R92, R105, R126, R128, R129, R130, R131, R132, R133: 22k; R_0402_1005Metric; Mfr. Part# RC0402FR-0722KL; Mouser Part# 603-RC0402FR-0722KL
R17, R43, R56, R69, R82, R95, R108, R118, R120, R121, R122, R123, R124, R125, R134, R136, R137, R138, R139, R140, R141: 620R; R_0402_1005Metric; Mfr. Part# RC0402FR-07620RL; Mouser Part# 603-RC0402FR-07620RL
TP3, TP9, TP12, TP15, TP18, TP21, TP24: PWM; TestPoint_Pad_D1.0mm
TP4, TP10, TP13, TP16, TP19, TP22, TP25: Voltage; TestPoint_Pad_D1.0mm
TP5, TP11, TP14, TP17, TP20, TP23, TP26: Current; TestPoint_Pad_D1.0mm
U5, U7, U8, U9, U10, U11, U12: TLV9052; SOT-23-8; Mfr. Part# TLV9052IDDFR; Mouser Part# 595-TLV9052IDDFR

Connections of its further copies:
/Balance1: C49.1; also elsewhere on the board
/Balance3: C51.1; also elsewhere on the board
/Balance4: C52.1; also elsewhere on the board
/Balance5: C53.1; also elsewhere on the board
/Balance6: C54.1; also elsewhere on the board
/Balance7: C55.1; also elsewhere on the board
/Balance8: C56.1; also elsewhere on the board
/Balancer1/Cell+: C10.1, C11.1, D2.1 (K), D26.1 (K), NT1.1, R12.1, R13.2, R15.1, U5.8 (V+); also elsewhere on the board
/Balancer2/Cell+: C19.2, C20.2, D4.2 (A), D20.2 (A), Q13.3 (S), R37.2, R40.2, U7.4 (V-); also elsewhere on the board
/Balancer3/Cell+: C20.1, C21.1, C24.2, C25.2, D4.1 (K), D5.2 (A), D21.2 (A), D28.1 (K), NT3.1, Q18.3 (S), R38.1, R39.2, R41.1, R50.2, R53.2, U7.8 (V+), U8.4 (V-); also elsewhere on the board
/Balancer5/Cell+: C30.1, C31.1, C34.2, C35.2, D6.1 (K), D7.2 (A), D23.2 (A), D30.1 (K), NT5.1, Q28.3 (S), R64.1, R65.2, R67.1, R76.2, R79.2, U9.8 (V+), U10.4 (V-); also elsewhere on the board
/Balancer6/Cell+: C35.1, C36.1, C39.2, C40.2, D7.1 (K), D8.2 (A), D24.2 (A), D31.1 (K), NT6.1, Q33.3 (S), R77.1, R78.2, R80.1, R89.2, R92.2, U10.8 (V+), U11.4 (V-); also elsewhere on the board
/Balancer7/Cell+: C40.1, C41.1, C44.2, C45.2, D8.1 (K), D9.2 (A), D25.2 (A), D32.1 (K), NT7.1, Q38.3 (S), R90.1, R91.2, R93.1, R102.2, R105.2, U11.8 (V+), U12.4 (V-); also elsewhere on the board
/Balancer8/Cell+: C45.1, C46.1, D9.1 (K), D33.1 (K), NT8.1, R103.1, R104.2, R106.1, U12.8 (V+); also elsewhere on the board
/CurrentCell1: C13.1, Q5.3 (D), R18.1, TP5.1; also elsewhere on the board
/CurrentCell3: C23.1, Q15.3 (D), R44.1, TP11.1; also elsewhere on the board
/CurrentCell4: C28.1, Q20.3 (D), R57.1, TP14.1; also elsewhere on the board
/CurrentCell5: C33.1, Q25.3 (D), R70.1, TP17.1; also elsewhere on the board
/CurrentCell6: C38.1, Q30.3 (D), R83.1, TP20.1; also elsewhere on the board
/CurrentCell7: C43.1, Q35.3 (D), R96.1, TP23.1; also elsewhere on the board
/CurrentCell8: C48.1, Q40.3 (D), R109.1, TP26.1; also elsewhere on the board
/Supply: C25.1, C26.1, C29.2, C30.2, D5.1 (K), D6.2 (A), D22.2 (A), D29.1 (K), NT4.1, Q23.3 (S), R51.1, R52.2, R54.1, R63.2, R66.2, U8.8 (V+), U9.4 (V-); also elsewhere on the board
/VoltageCell1: C12.1, Q4.3 (D), R16.1, TP4.1; also elsewhere on the board
/VoltageCell3: C22.1, Q14.3 (D), R42.1, TP10.1; also elsewhere on the board
/VoltageCell4: C27.1, Q19.3 (D), R55.1, TP13.1; also elsewhere on the board
/VoltageCell5: C32.1, Q24.3 (D), R68.1, TP16.1; also elsewhere on the board
/VoltageCell6: C37.1, Q29.3 (D), R81.1, TP19.1; also elsewhere on the board
/VoltageCell7: C42.1, Q34.3 (D), R94.1, TP22.1; also elsewhere on the board
/VoltageCell8: C47.1, Q39.3 (D), R107.1, TP25.1; also elsewhere on the board
GND: C9.2, C10.2, C12.2, C13.2, C22.2, C23.2, C27.2, C28.2, C32.2, C33.2, C37.2, C38.2, C42.2, C43.2, C47.2, C48.2, D2.2 (A), D18.2 (A), Q3.3 (S), R11.2, R14.2, R16.2, R18.2, R42.2, R44.2, R55.2, R57.2, R68.2, R70.2, R81.2, R83.2, R94.2, R96.2, R107.2, R109.2, U5.4 (V-); also elsewhere on the board
unnamed: C49.2, R126.1, R134.2, TP3.1
unnamed: C51.2, R128.1, R136.2, TP9.1
unnamed: C52.2, R129.1, R137.2, TP12.1
unnamed: C53.2, R130.1, R138.2, TP15.1
unnamed: C54.2, R131.1, R139.2, TP18.1
unnamed: C55.2, R132.1, R140.2, TP21.1
unnamed: C56.2, R133.1, R141.2, TP24.1
unnamed: D10.2 (A), R126.2
unnamed: C9.1, D10.1 (K), D26.2 (A), Q3.1 (G), R11.1
unnamed: D12.2 (A), R128.2
unnamed: C19.1, D12.1 (K), D28.2 (A), Q13.1 (G), R37.1
unnamed: D13.2 (A), R129.2
unnamed: C24.1, D13.1 (K), D29.2 (A), Q18.1 (G), R50.1
unnamed: D14.2 (A), R130.2
unnamed: C29.1, D14.1 (K), D30.2 (A), Q23.1 (G), R63.1
unnamed: D15.2 (A), R131.2
unnamed: C34.1, D15.1 (K), D31.2 (A), Q28.1 (G), R76.1
unnamed: D16.2 (A), R132.2
unnamed: C39.1, D16.1 (K), D32.2 (A), Q33.1 (G), R89.1
unnamed: D17.2 (A), R133.2
unnamed: C44.1, D17.1 (K), D33.2 (A), Q38.1 (G), R102.1
unnamed: D18.1 (K), R134.1
unnamed: D20.1 (K), R136.1
unnamed: D21.1 (K), R137.1
unnamed: D22.1 (K), R138.1
unnamed: D23.1 (K), R139.1
unnamed: D24.1 (K), R140.1
unnamed: D25.1 (K), R141.1
unnamed: NT1.2, R17.1
unnamed: NT3.2, R43.1
unnamed: NT4.2, R56.1
unnamed: NT5.2, R69.1
unnamed: NT6.2, R82.1
unnamed: NT7.2, R95.1
unnamed: NT8.2, R108.1
unnamed: Q3.2 (D), R12.2, R118.1
unnamed: Q4.1 (G), U5.1
unnamed: Q4.2 (S), R15.2, U5.2 (-)
unnamed: Q5.1 (G), U5.7
unnamed: Q5.2 (S), R17.2, U5.6 (-)
unnamed: Q13.2 (D), R38.2, R120.1
unnamed: Q14.1 (G), U7.1
unnamed: Q14.2 (S), R41.2, U7.2 (-)
unnamed: Q15.1 (G), U7.7
unnamed: Q15.2 (S), R43.2, U7.6 (-)
unnamed: Q18.2 (D), R51.2, R121.1
unnamed: Q19.1 (G), U8.1
unnamed: Q19.2 (S), R54.2, U8.2 (-)
unnamed: Q20.1 (G), U8.7
unnamed: Q20.2 (S), R56.2, U8.6 (-)
unnamed: Q23.2 (D), R64.2, R122.1
unnamed: Q24.1 (G), U9.1
unnamed: Q24.2 (S), R67.2, U9.2 (-)
unnamed: Q25.1 (G), U9.7
unnamed: Q25.2 (S), R69.2, U9.6 (-)
unnamed: Q28.2 (D), R77.2, R123.1
unnamed: Q29.1 (G), U10.1
unnamed: Q29.2 (S), R80.2, U10.2 (-)
unnamed: Q30.1 (G), U10.7
unnamed: Q30.2 (S), R82.2, U10.6 (-)
unnamed: Q33.2 (D), R90.2, R124.1
unnamed: Q34.1 (G), U11.1
unnamed: Q34.2 (S), R93.2, U11.2 (-)
unnamed: Q35.1 (G), U11.7
unnamed: Q35.2 (S), R95.2, U11.6 (-)
unnamed: Q38.2 (D), R103.2, R125.1
unnamed: Q39.1 (G), U12.1
unnamed: Q39.2 (S), R106.2, U12.2 (-)
unnamed: Q40.1 (G), U12.7
unnamed: Q40.2 (S), R108.2, U12.6 (-)
unnamed: C11.2, R13.1, R14.1, U5.3 (+)
unnamed: R118.2, U5.5 (+)
unnamed: C21.2, R39.1, R40.1, U7.3 (+)
unnamed: R120.2, U7.5 (+)
unnamed: C26.2, R52.1, R53.1, U8.3 (+)
unnamed: R121.2, U8.5 (+)
unnamed: C31.2, R65.1, R66.1, U9.3 (+)
unnamed: R122.2, U9.5 (+)
unnamed: C36.2, R78.1, R79.1, U10.3 (+)
unnamed: R123.2, U10.5 (+)
unnamed: C41.2, R91.1, R92.1, U11.3 (+)
unnamed: R124.2, U11.5 (+)
unnamed: C46.2, R104.1, R105.1, U12.3 (+)
unnamed: R125.2, U12.5 (+)

Notes on the sheet:
P_{FET,max} = 32V * 168uA = 5.4mW
420Hz
tau = 10ms
Vgs margin to rail -3.1~-4.4V @ 161uA
I_{leakage,max} = 1uA
P_{Shunt} = (1A)^2 * 0.1R = 0.1W P_{0603,max} = 0.1~0.2W
0.44~0.79V max. 0.825V @VDD/4
Vgs margin to rail -2.06~-3.71V @ 94~168uA
Vgs = 0~3.1V TO251 (IPAK) 1.5A @ 2.5V
Ibal = 0~1A Vcm = 3.1~4.4V @ 1A
4.7k / (4.7k + 22k) * 4.7k / 4.7k = 0.176 V_{Cell,max} = 0.825V / 0.176 = 4.69V
0.44~0.79V
0.1R * 4.7k / 620R = 0.758 I_{bal,max} = 0.825V / 0.758 = 1.09A
0~0.76V max. 0.825V @VDD/4
0~0.1V
Vcell = 2.5~4.5V Vcm = 2.06~3.71V

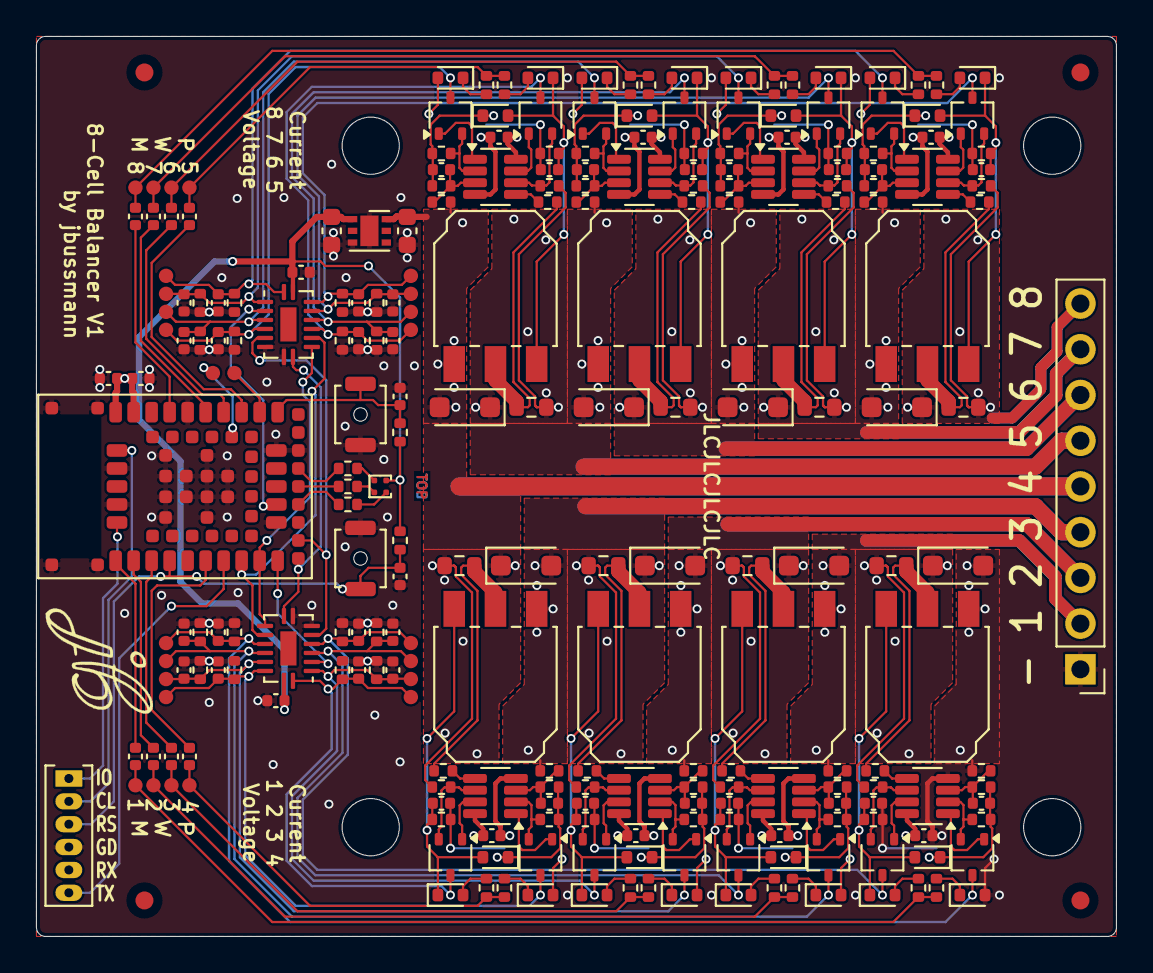
[picture p20: board 8-Cell Balancer.kicad_pcb from above]

Board: 2 copper layers, 60.0 x 50.0 mm, 260 parts (0 on the bottom side), 149 nets.
