jbussmann/8-Cell-Balancer/Firmware/ble_services.h

#ifndef BLE_SERVICES_H
#define BLE_SERVICES_H

#include <stdint.h>

#include "bluetooth.h"

// 2 bytes * (8 voltages + 8 currents) * 6 data points per notification
#define BLE_HISTORY_CHAR_LENGTH (sizeof(uint16_t) * (8 + 8) * 6)

enum { VALUES, DEVIATIONS, HISTORY_1H, HISTORY_12H, PWM_SET };

void ble_notify_cell_values(uint16_t values[16], uint8_t type);
void ble_notify_history_values(uint16_t values[16], uint8_t type);
void ble_service_init(ble_os_t *p_service);

#endif  // BLE_SERVICES_H
