jbussmann/8-Cell-Balancer/(commit log)

2024-01-10 Project init
    [8-Cell Balancer Charger.kicad_pcb, 8-Cell Balancer Charger.kicad_sch, Balancer.kicad_sch, Blancer1-8.kicad_sch, _Teileliste.ods]
2024-01-10 stream 24-01-10
    [8-Cell Balancer Charger.kicad_pcb, 8-Cell Balancer Charger.kicad_sch, Balancer.kicad_sch, Blancer1-8.kicad_sch, _Teileliste.ods]
2024-01-24 stream 24-01-24
    [8-Cell Balancer Charger.kicad_pcb, Blancer1-8.kicad_sch]
2024-02-18 finishing touches in preparation for manufacturing
    [8-Cell Balancer Charger.kicad_pcb, 8-Cell Balancer Charger.kicad_sch, 8-Cell Balancer.kicad_pcb, 8-Cell Balancer.kicad_sch, Balancer.kicad_sch, Blancer1-8.kicad_sch, _Teileliste.ods]
2024-02-18 add fabrication files
    [8-Cell Balancer-B_Cu.gbl, 8-Cell Balancer-B_Mask.gbs, 8-Cell Balancer-B_Silkscreen.gbo, 8-Cell Balancer-Edge_Cuts.gm1, 8-Cell Balancer-F_Cu.gtl, 8-Cell Balancer-F_Mask.gts, 8-Cell Balancer-F_Paste.gtp, 8-Cell Balancer-F_Silkscreen.gto]
2024-02-25 finalize component values
    [8-Cell Balancer.kicad_sch, Blancer1-8.kicad_sch]
2024-02-25 order components
    [_Teileliste.ods]
2024-03-05 generate BOM
    [8-Cell Balancer.kicad_pcb, 8-Cell Balancer.kicad_sch, Blancer1-8.kicad_sch]
2024-03-20 schematic error correction
    [8-Cell Balancer.kicad_sch]
2024-04-07 firmware: extensive architecture rework around adc sample swaps
    [adc.c, ble_services.c, ble_services.h, bluetooth.c, bluetooth.h, board.h, log.c]
2024-04-19 Host-App: added range switching
2024-10-12 hardware: update to KiCad 7
    [8-Cell Balancer.kicad_pcb, 8-Cell Balancer.kicad_sch, Blancer1-8.kicad_sch]
2025-03-06 hardware: version 1
    [8-Cell Balancer-B_Cu.gbl, 8-Cell Balancer-B_Mask.gbs, 8-Cell Balancer-B_Silkscreen.gbo, 8-Cell Balancer-Edge_Cuts.gm1, 8-Cell Balancer-F_Cu.gtl, 8-Cell Balancer-F_Mask.gts, 8-Cell Balancer-F_Paste.gtp, 8-Cell Balancer-F_Silkscreen.gto]
